AlpineAce27/Senior-Project-TVC-Guidance/Documentation/Pictures/01-29-24 TVC.jpg

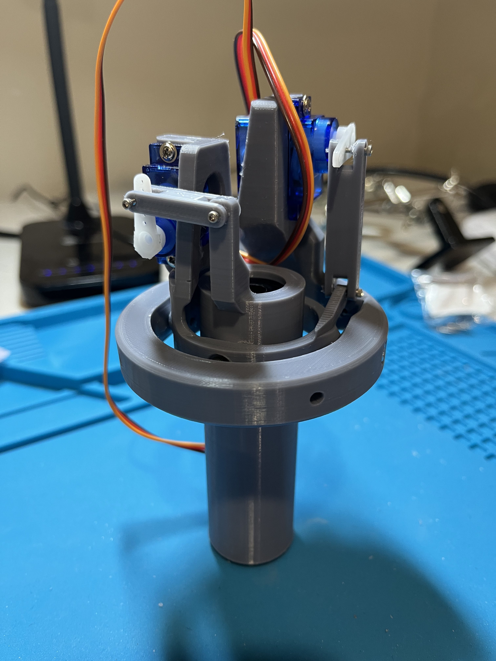
Documentation/Pictures/01-29-24 TVC.jpg
