AlpineAce27/Senior-Project-TVC-Guidance/Genesis Flight Computer/PCB Gerber Files/CAMOutputs/Assembly/R1 Schematic.txt

Partlist exported from C:/Users/Kimball/Documents/EAGLE/projects/Genesis Flight Computer/R1 Schematic.sch at 3/7/2024 11:54 AM

Qty Value                             Device                            Package                           Parts                          Description                                                                                                                                                                                                                                           MF MPN OC_FARNELL OC_NEWARK POPULARITY
3                                     LED3MM                            LED3MM                            BLUE_LED, GREEN_LED, RED_LED   LED                                                                                                                                                                                                                                                                               97        
1                                     MOSFET-NGDS_TO220V                TO220V                            PYRO_MOSFET                    N-Channel Mosfet                                                                                                                                                                                                                                                                            
4                                     PINHD-1X3                         1X03                              SERVO1, SERVO2, SERVO3, SERVO4 PIN HEADER                                                                                                                                                                                                                                                                                  
1                                     PINHD-1X6                         1X06                              EXTRA_HEADERS                  PIN HEADER                                                                                                                                                                                                                                                                                  
1   1 uF                              CPOL-USE2,5-6E                    E2,5-6E                           C3                             POLARIZED CAPACITOR, American symbol                                                                                                                                                                                                                                                        
1   10 uF                             CPOL-USE2.5-6                     E2,5-6                            C2                             POLARIZED CAPACITOR, American symbol                                                                                                                                                                                                                                                        
1   140 ohm                           FLIPFLOP-RES                      0805-THM                          R2                             Flip Flop resistor                                                                                                                                                                                                                                                                          
1   1X2-3.5MM                         1X2-3.5MM                         1X2-3.5MM                         PYRO1                          3.5mm Terminal block                                                                                                                                                                                                                                                                        
1   1ohm                              FLIPFLOP-RES                      0805-THM                          R1-2                           Flip Flop resistor                                                                                                                                                                                                                                                                          
1   500ohm                            FLIPFLOP-RES                      0805-THM                          R1-1                           Flip Flop resistor                                                                                                                                                                                                                                                                          
1   7808T                             7808T                             TO220H                            IC1                            Positive VOLTAGE REGULATOR                                                                                                                                                                                                                                                        0         
1   90 ohm                            FLIPFLOP-RES                      0805-THM                          R1                             Flip Flop resistor                                                                                                                                                                                                                                                                          
1   ADAFRUIT_BMP280_BREAKOUT_STEMMAQT ADAFRUIT_BMP280_BREAKOUT_STEMMAQT ADAFRUIT_BMP280_BREAKOUT_STEMMAQT U$4                                                                                                                                                                                                                                                                                                                        
1   ADAFRUIT_MICRO_SD_BREAKOUT+       ADAFRUIT_MICRO_SD_BREAKOUT+       ADAFRUIT_MICRO_SD_BREAKOUT        U$2                                                                                                                                                                                                                                                                                                                        
1   ADAFRUIT_SP_SMT_512M_SD           ADAFRUIT_SP_SMT_512M_SD           ADAFRUIT_SPI_SMT_512M_SD          U$3                                                                                                                                                                                                                                                                                                                        
1   Arming Header                     PINHD-1X3                         1X03                              JP1                            PIN HEADER                                                                                                                                                                                                                                                                                  
1   F/TMB                             F/TMB                             F/TMB                             SG1                            BUZZER Source: Buerklin                                                                                                                                                                                                                                      unknown    unknown   1         
1   GY-521MPU6050                     GY-521MPU6050                     GY-521                            U1                                                                                                                                                                                                                                                                                                                         
1   TEENSY40                          TEENSY40                          TEENSY40                          U$1                            Teensy 4.0 device including POGO pins for pins 24 - 33, but not yet pins for D+ and D-.  Symbol layout is what works for me and may not suite everyone... that can be added or additional symbols can be created to be used in a modilied davie name.                                       
2   WIREPAD3,81/1,4                   WIREPAD3,81/1,4                   3,81/1,4                          BATT-GND, BATT-VIN             Wire PAD connect wire on PCB                                                                                                                                                                                                                                                      1
