AlpineAce27/Senior-Project-TVC-Guidance/Documentation/Pictures/02-22-24 Generic Graph.png

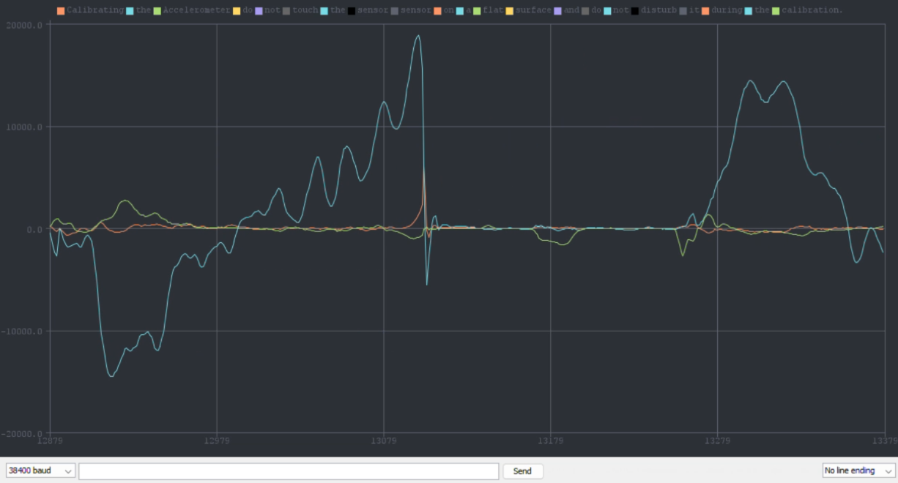
Documentation/Pictures/02-22-24 Generic Graph.png
