AlpineAce27/Senior-Project-TVC-Guidance/Documentation/Pictures/02-22-24 Genesis Flight Computer .png

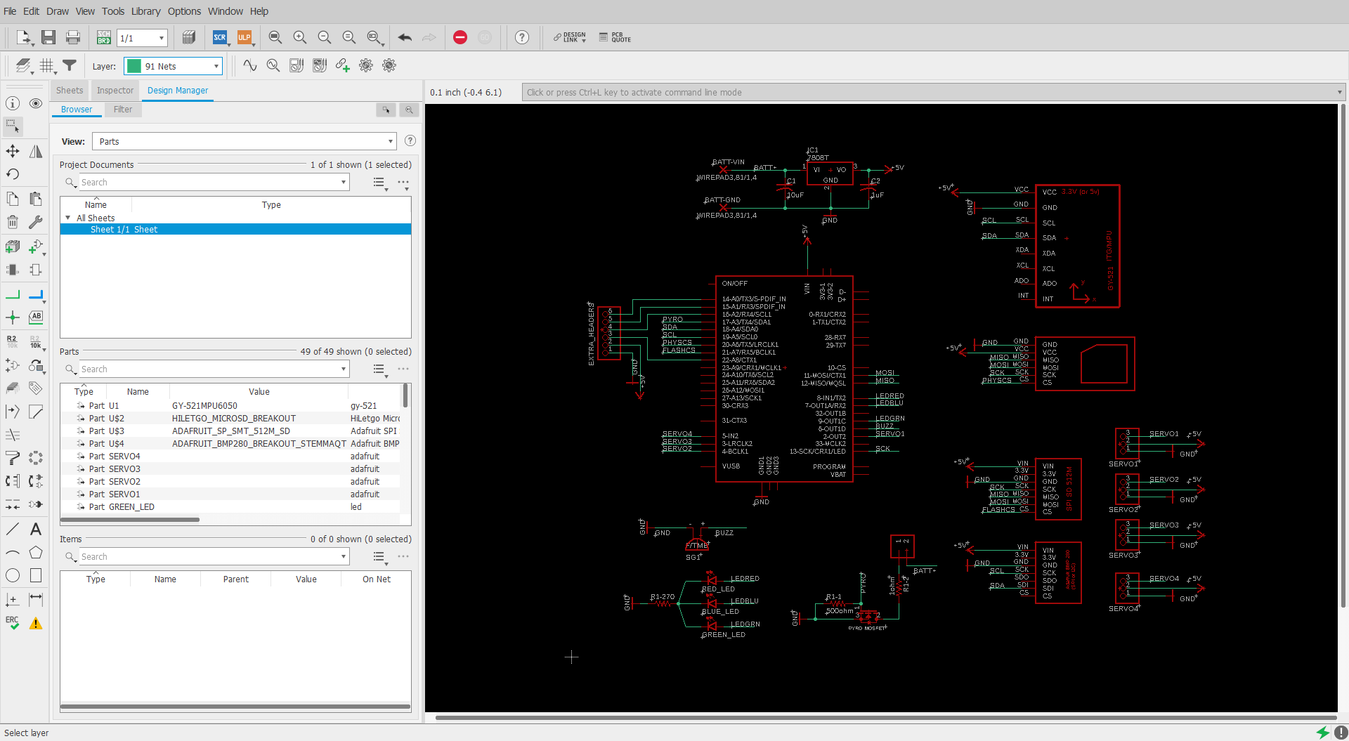
Documentation/Pictures/02-22-24 Genesis Flight Computer .png
