AlpineAce27/Senior-Project-TVC-Guidance/Documentation/Pictures/02-22-24 Genesis Launch Computer Board.png

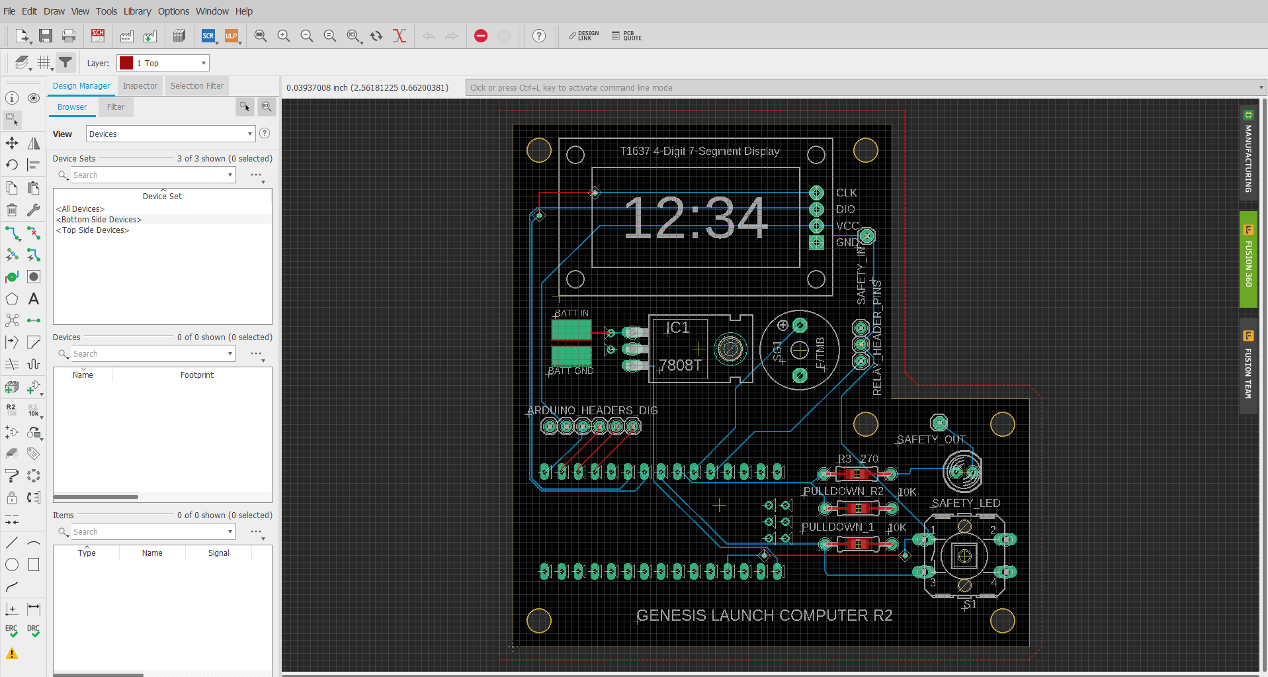
Documentation/Pictures/02-22-24 Genesis Launch Computer Board.png
