AlpineAce27/Senior-Project-TVC-Guidance/Documentation/Pictures/02-22-24 PID WIP Code.png

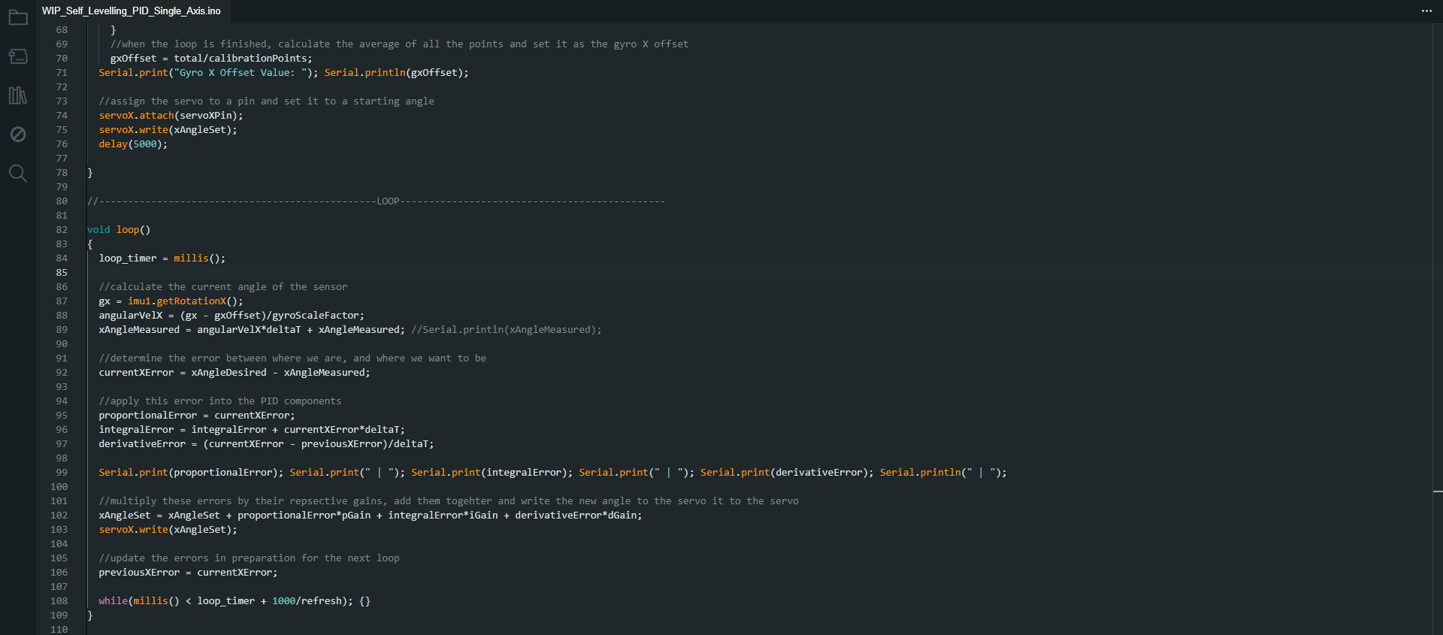
Documentation/Pictures/02-22-24 PID WIP Code.png
