AlpineAce27/Senior-Project-TVC-Guidance/Documentation/Pictures/Screenshot 2024-04-12 120832.png

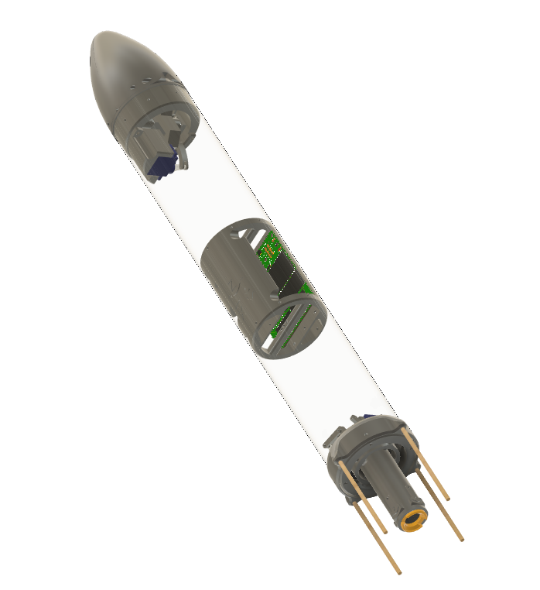
Documentation/Pictures/Screenshot 2024-04-12 120832.png
