AlpineAce27/Senior-Project-TVC-Guidance/Documentation/Pictures/Screenshot 2024-04-12 120903.png

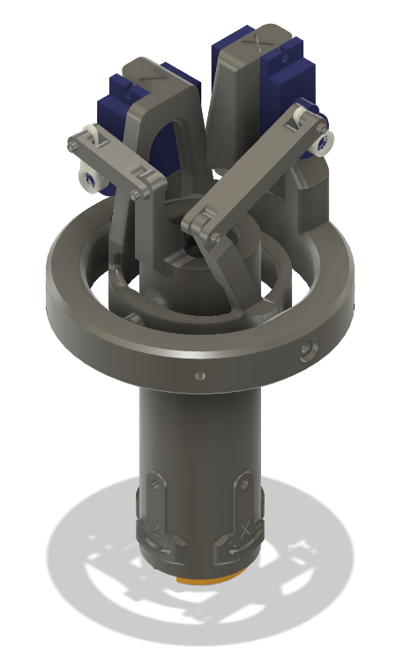
Documentation/Pictures/Screenshot 2024-04-12 120903.png
