AlpineAce27/Senior-Project-TVC-Guidance/Documentation/Pictures/Screenshot 2024-04-15 211354.png

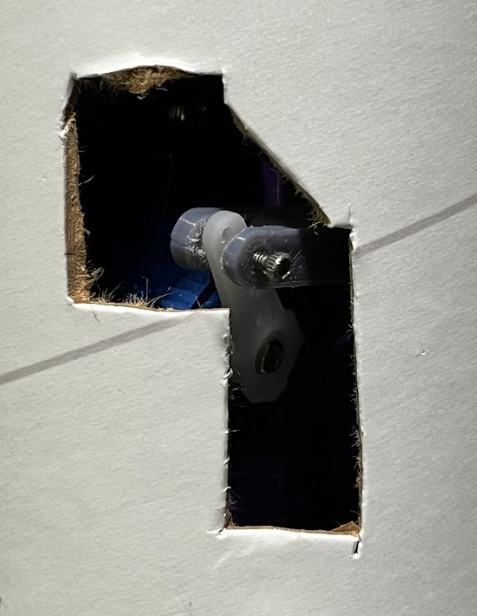
Documentation/Pictures/Screenshot 2024-04-15 211354.png
