AlpineAce27/Senior-Project-TVC-Guidance/Documentation/Pictures/Screenshot 2024-04-19 132711.png

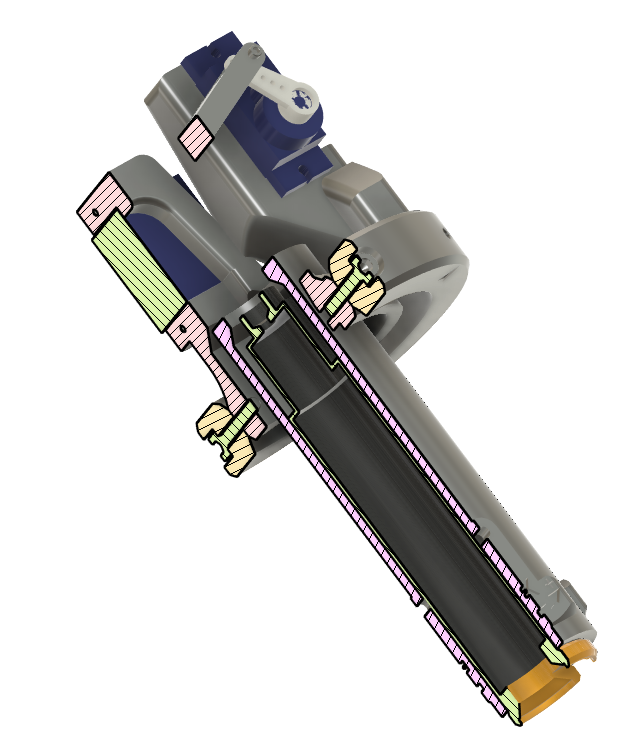
Documentation/Pictures/Screenshot 2024-04-19 132711.png
