AlpineAce27/Senior-Project-TVC-Guidance/Documentation/Pictures/Screenshot 2024-04-19 133153.png

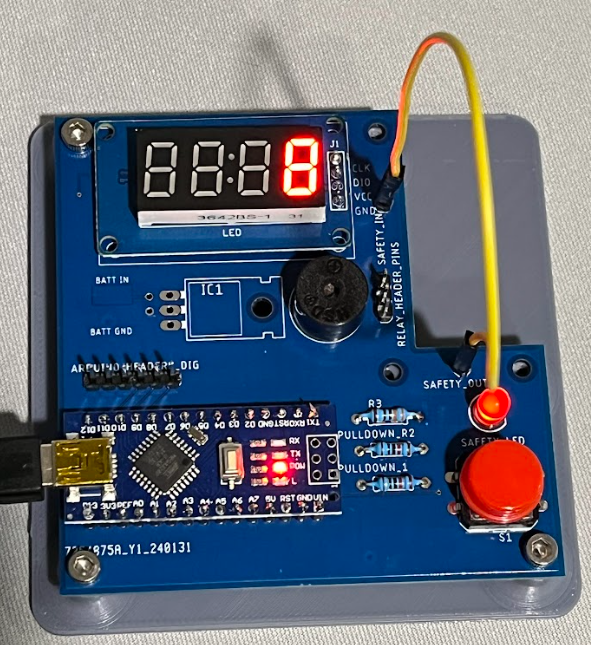
Documentation/Pictures/Screenshot 2024-04-19 133153.png
