AlpineAce27/Senior-Project-TVC-Guidance/Genesis Flight Computer/Documentation/Screenshot 2024-04-17 100612.png

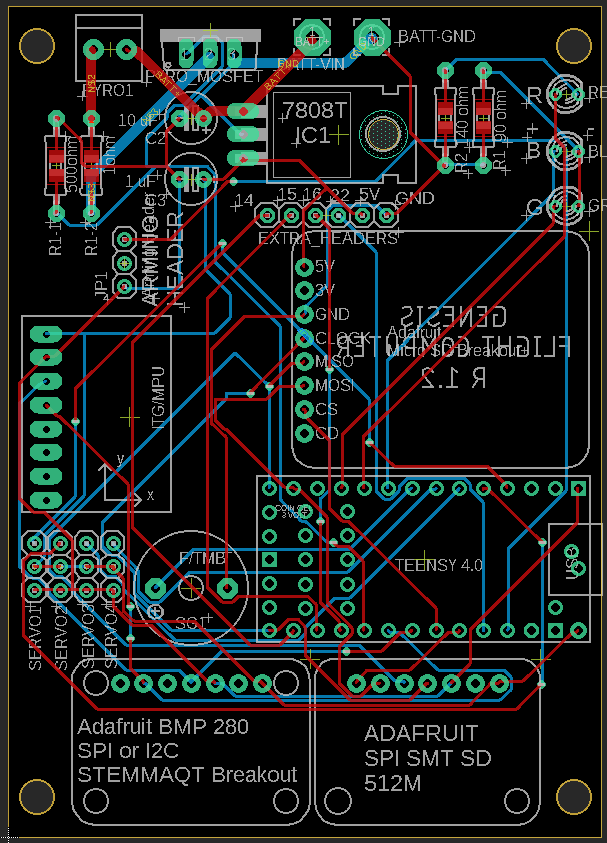
Genesis Flight Computer/Documentation/Screenshot 2024-04-17 100612.png
