AlpineAce27/Senior-Project-TVC-Guidance/Genesis Flight Computer/Documentation/Screenshot 2024-04-20 150324.png

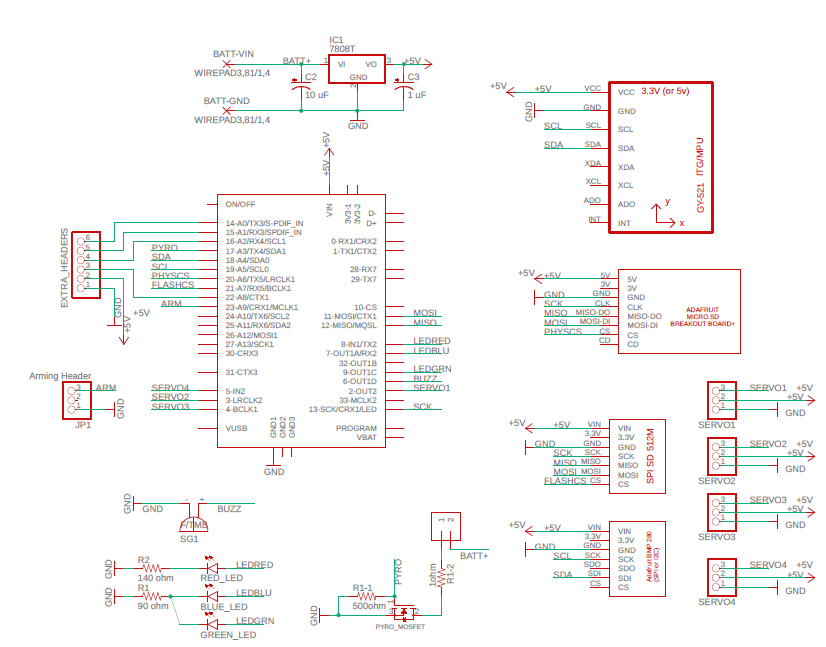
Genesis Flight Computer/Documentation/Screenshot 2024-04-20 150324.png
