AlpineAce27/Senior-Project-TVC-Guidance/Genesis Launch Computer/Documentation/GLC Schematic.png

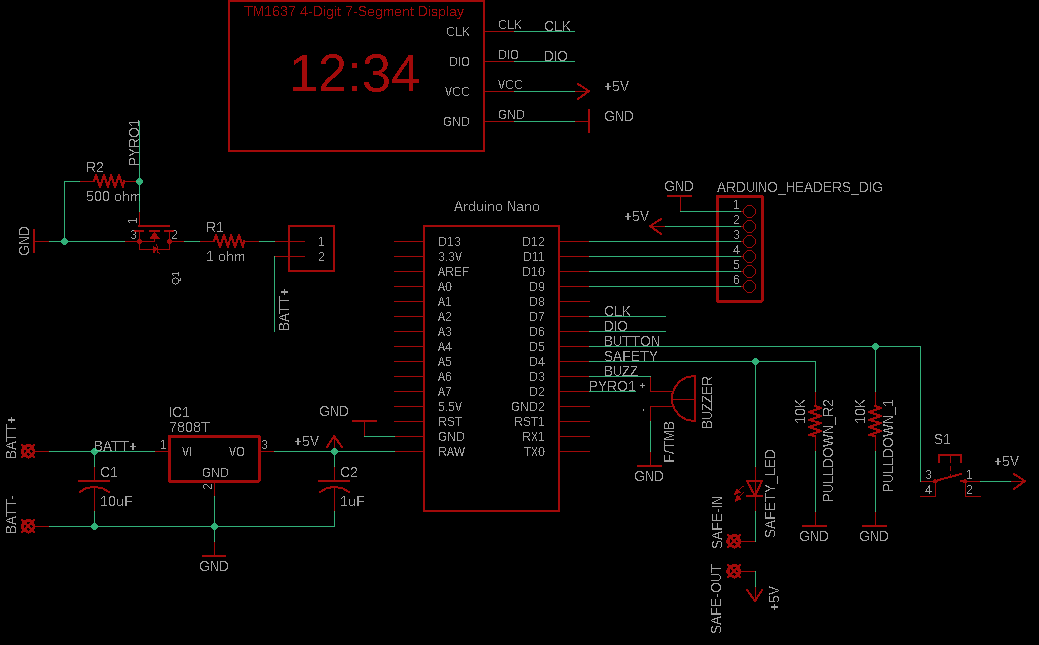
Genesis Launch Computer/Documentation/GLC Schematic.png
