AlpineAce27/Senior-Project-TVC-Guidance/Genesis Launch Computer/Documentation/Screenshot 2024-04-15 204919.png

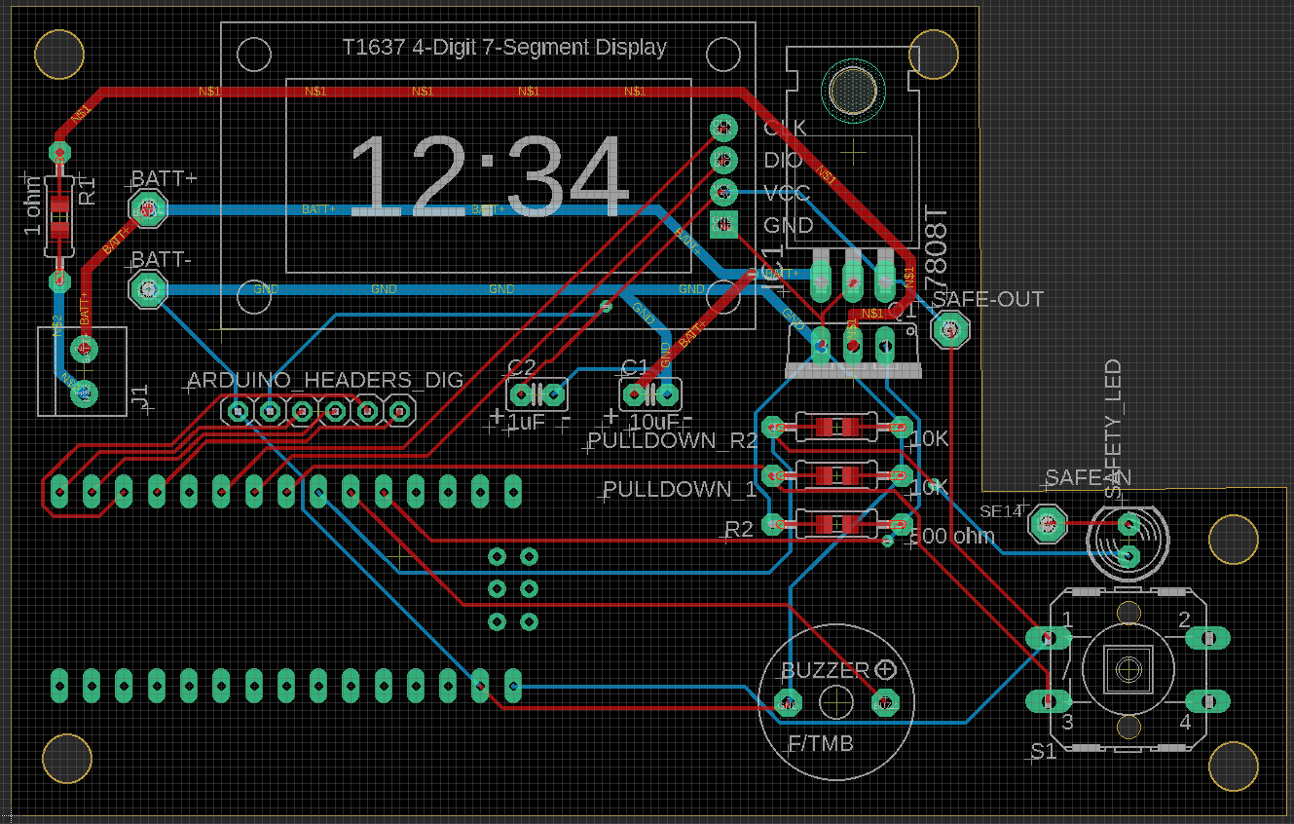
Genesis Launch Computer/Documentation/Screenshot 2024-04-15 204919.png
