AlpineAce27/Senior-Project-TVC-Guidance/Genesis Launch Computer/Documentation/Screenshot 2024-04-20 150143.png

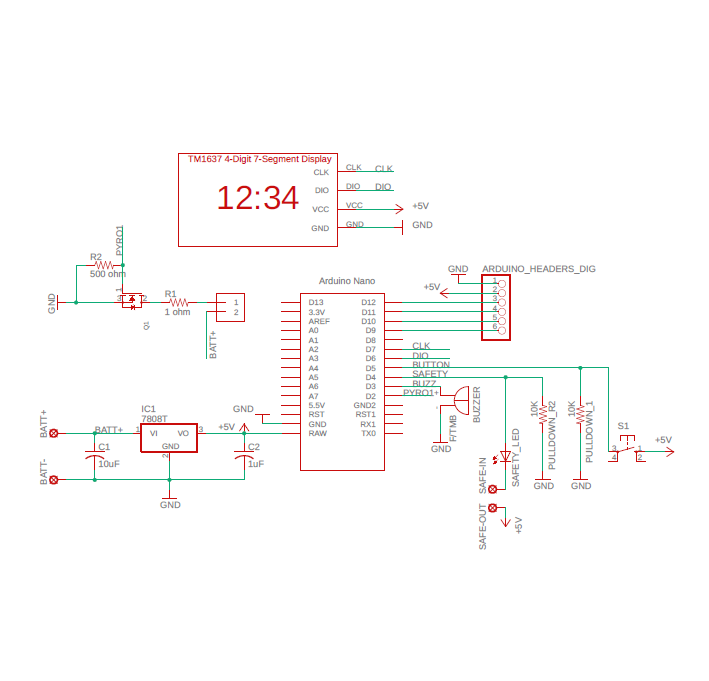
Genesis Launch Computer/Documentation/Screenshot 2024-04-20 150143.png
