AlpineAce27/Senior-Project-TVC-Guidance/Genesis Launch Computer/STLs/Case Top.stl

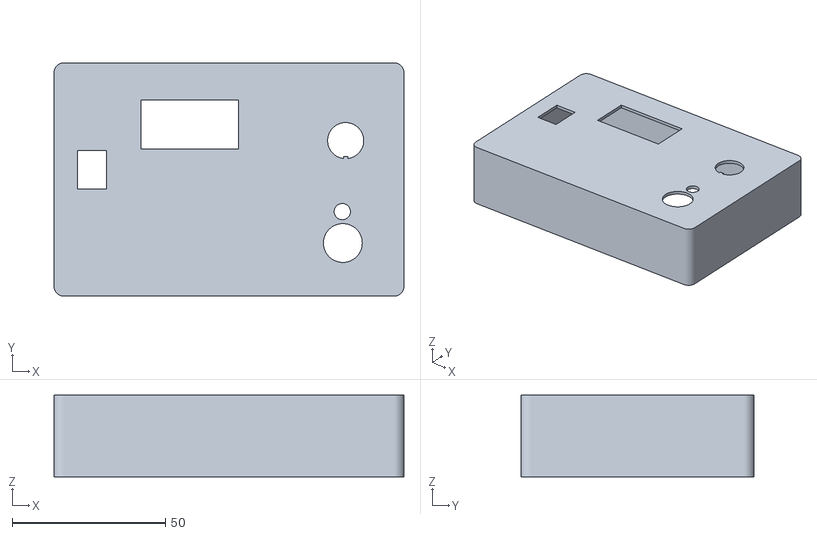
[picture p21: CAD file, 2024-03-28]
Genesis Launch Computer/STLs/Case Top.stl
114.3 x 76.2 x 26.7
