AlpineAce27/Senior-Project-TVC-Guidance/Genesis Rocket/STLs/Battery Spacer.stl

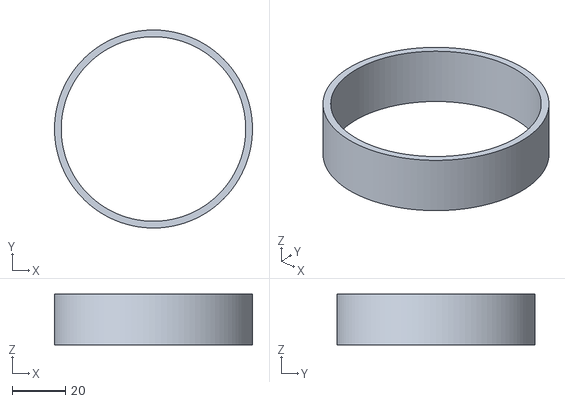
[picture p22: CAD file, 2024-04-20]
Genesis Rocket/STLs/Battery Spacer.stl
74.2 x 74.2 x 19.0
