AlpineAce27/Senior-Project-TVC-Guidance/Genesis Rocket/STLs/Launch Mount/Rocket-Side Launch Mount.stl

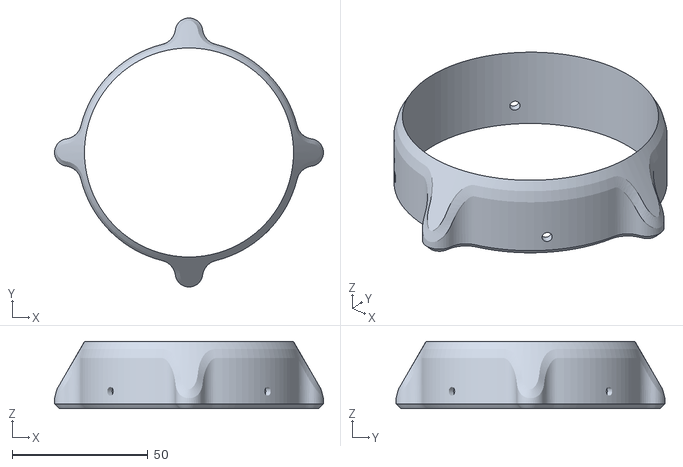
[picture p23: CAD file, 2024-02-09]
Genesis Rocket/STLs/Launch Mount/Rocket-Side Launch Mount.stl
99.1 x 99.1 x 24.7
