AlpineAce27/Senior-Project-TVC-Guidance/Genesis Rocket/STLs/Nosecone/Servo Mount.stl

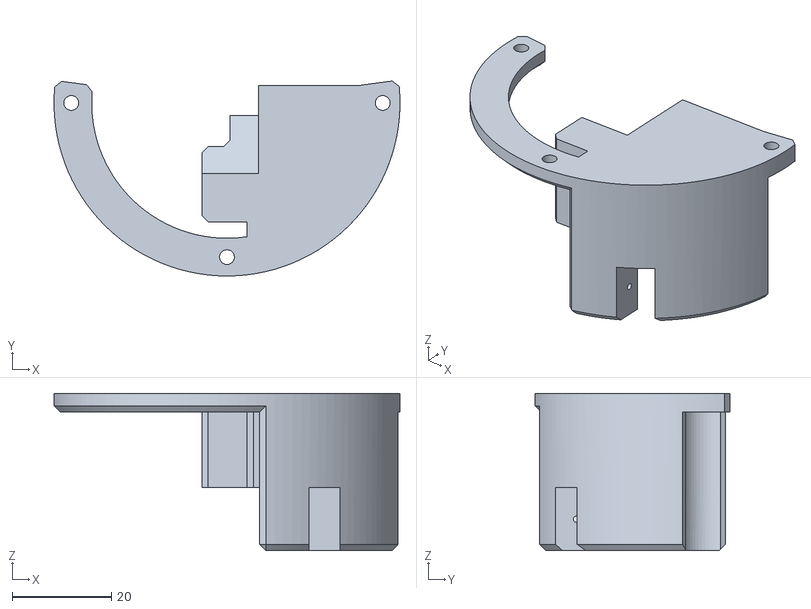
[picture p24: CAD file, 2024-03-28]
Genesis Rocket/STLs/Nosecone/Servo Mount.stl
69.8 x 39.4 x 31.8
