AlpineAce27/Senior-Project-TVC-Guidance/Genesis Rocket/STLs/TVC/Motor Sleeve.stl

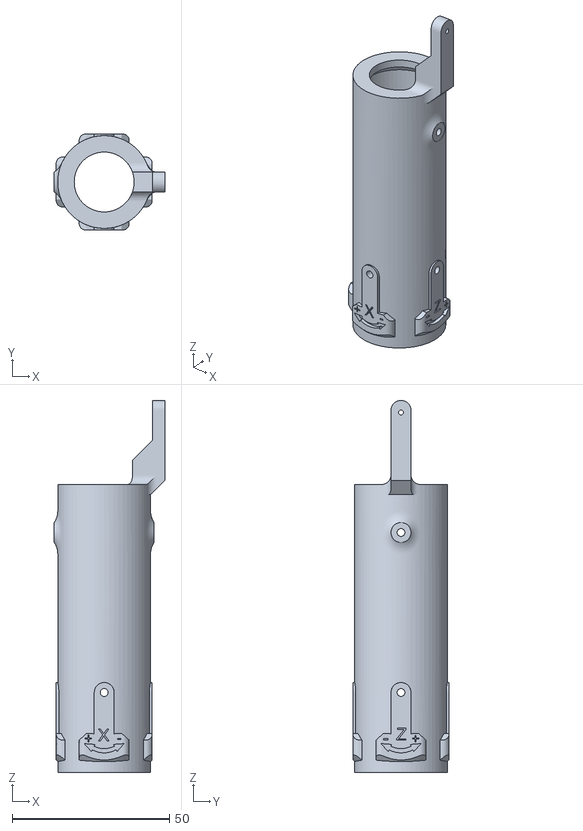
[picture p25: CAD file, 2024-03-12]
Genesis Rocket/STLs/TVC/Motor Sleeve.stl
35.1 x 30.5 x 118.1
