AlpineAce27/Senior-Project-TVC-Guidance/Miniprojects/Self Levelling PID (Single Axis)/STLs/Linkage Arm.stl

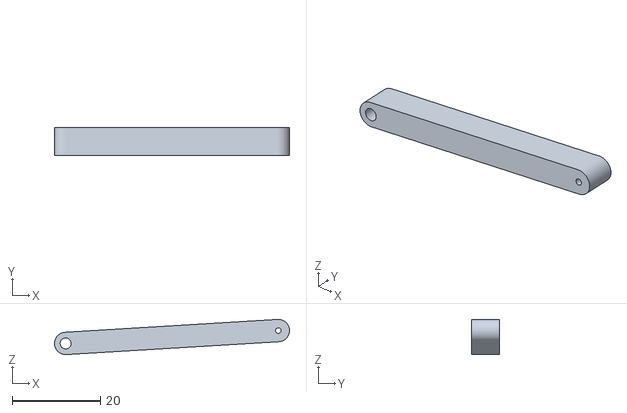
[picture p26: CAD file, 2024-04-02]
Miniprojects/Self Levelling PID (Single Axis)/STLs/Linkage Arm.stl
53.4 x 6.35 x 7.99
