AlpineAce27/Senior-Project-TVC-Guidance/Test Stand/STLs/Outer Ring.stl

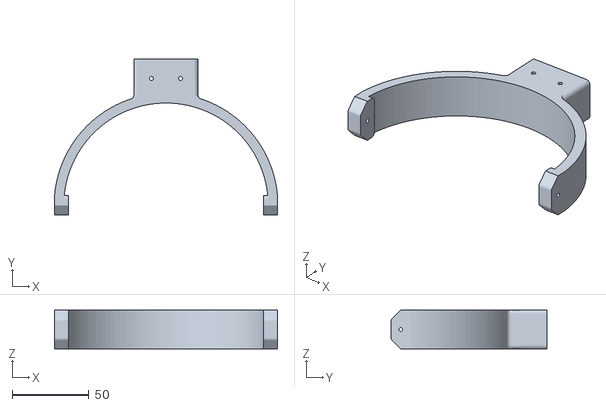
[picture p27: CAD file, 2024-04-12]
Test Stand/STLs/Outer Ring.stl
145.5 x 101.7 x 25.4
