AlpineAce27/Senior-Project-TVC-Guidance/Genesis Launch Computer/STLs/Case Bottom.stl

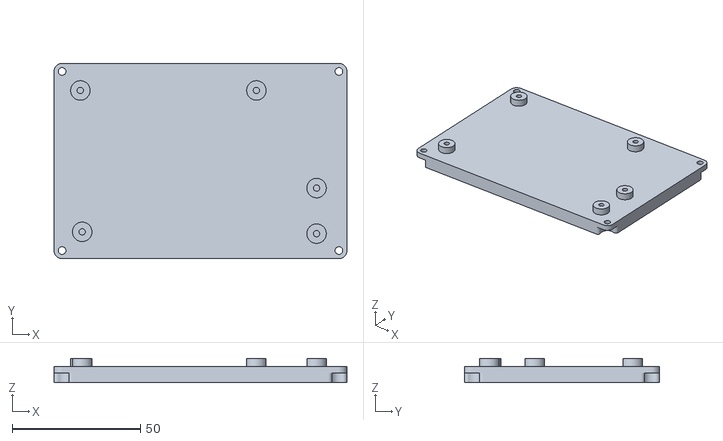
[picture p28: CAD file, 2024-03-12]
Genesis Launch Computer/STLs/Case Bottom.stl
114.3 x 76.2 x 9.52
