AlpineAce27/Senior-Project-TVC-Guidance/Genesis Rocket/STLs/Ejection Charge Powder Container.stl

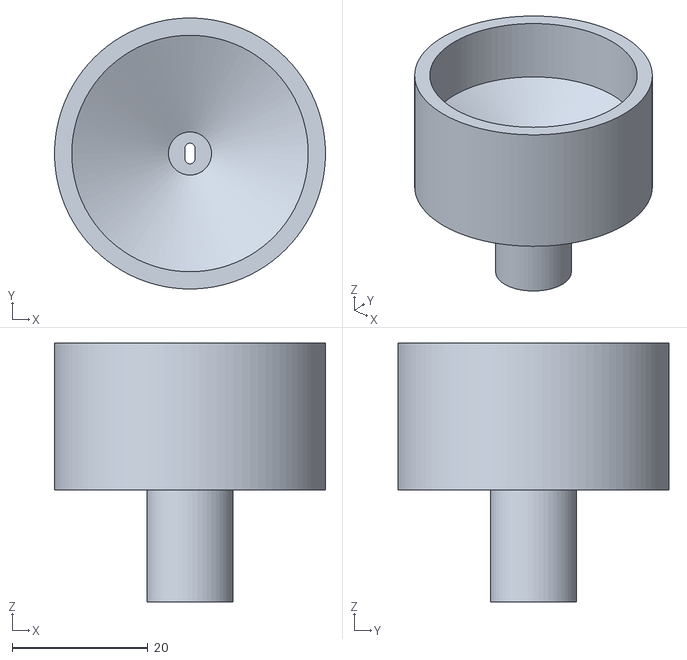
[picture p29: CAD file, 2024-04-12]
Genesis Rocket/STLs/Ejection Charge Powder Container.stl
39.9 x 39.9 x 38.1
