AlpineAce27/Senior-Project-TVC-Guidance/Genesis Rocket/STLs/Launch Mount/Pad-Side Launch Mount.stl

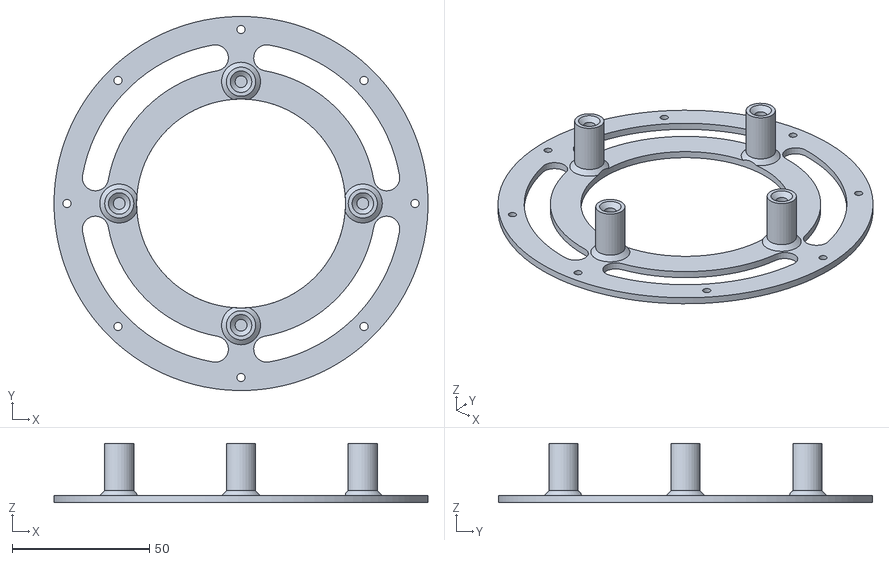
[picture p30: CAD file, 2024-02-09]
Genesis Rocket/STLs/Launch Mount/Pad-Side Launch Mount.stl
136.5 x 136.5 x 21.6
