AlpineAce27/Senior-Project-TVC-Guidance/Genesis Rocket/STLs/Nosecone/Piston Slider.stl

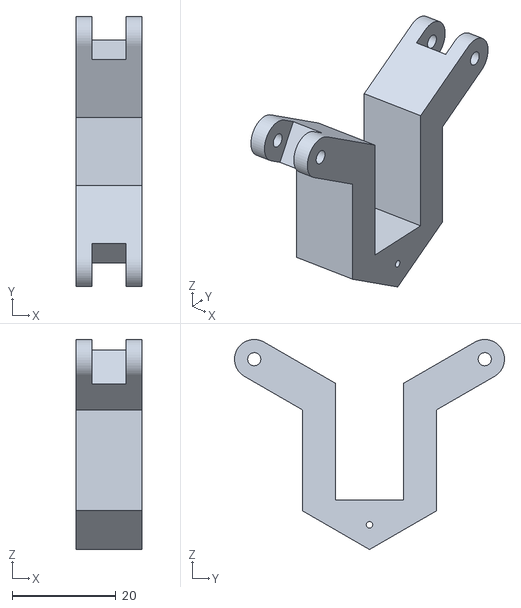
[picture p31: CAD file, 2024-03-28]
Genesis Rocket/STLs/Nosecone/Piston Slider.stl
12.7 x 52.1 x 40.5
