AlpineAce27/Senior-Project-TVC-Guidance/Genesis Rocket/STLs/TVC/Outer Gimbal Ring.stl

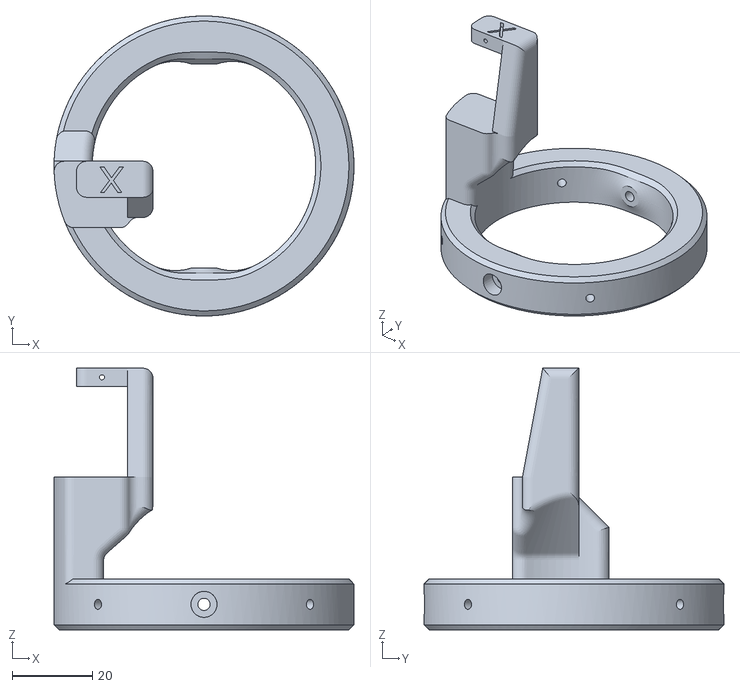
[picture p32: CAD file, 2024-03-12]
Genesis Rocket/STLs/TVC/Outer Gimbal Ring.stl
74.7 x 74.7 x 65.2
