AlpineAce27/Senior-Project-TVC-Guidance/Miniprojects/Self Levelling PID (Single Axis)/STLs/IMU Arm.stl

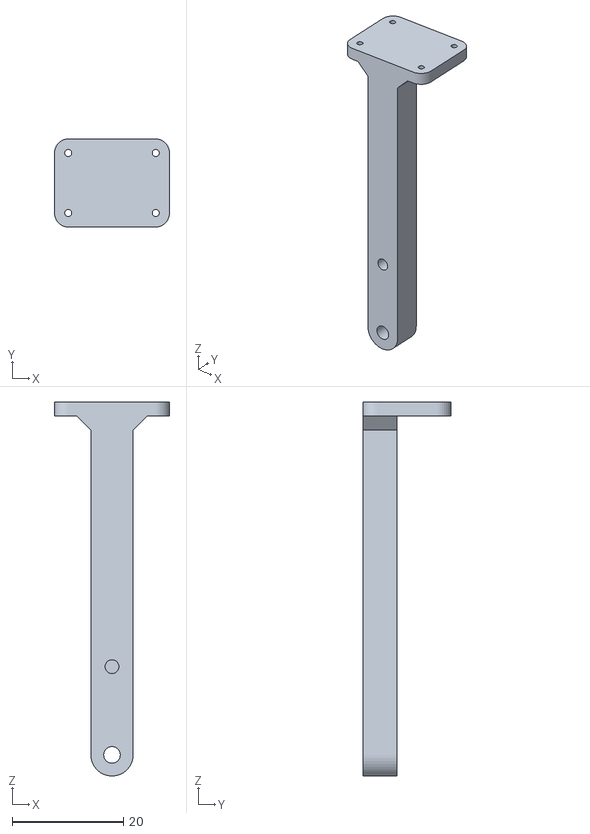
[picture p33: CAD file, 2024-04-02]
Miniprojects/Self Levelling PID (Single Axis)/STLs/IMU Arm.stl
20.7 x 15.9 x 67.3
