AlpineAce27/Senior-Project-TVC-Guidance/Test Stand/STLs/Thrust Meauring RC Motor Plate.stl

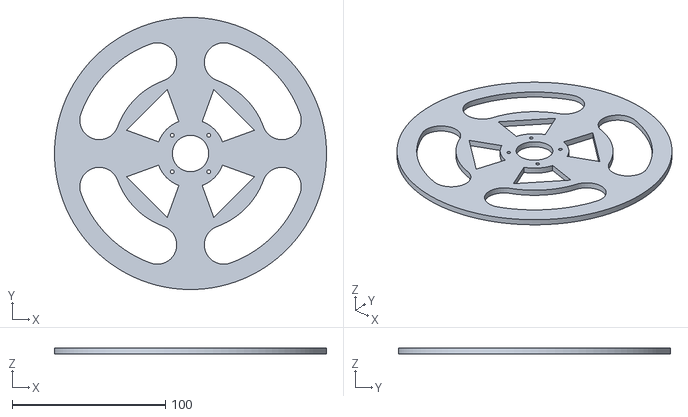
[picture p34: CAD file, 2024-04-12]
Test Stand/STLs/Thrust Meauring RC Motor Plate.stl
177.8 x 177.8 x 3.81
