AlpineAce27/Senior-Project-TVC-Guidance/Genesis Launch Computer/STLs/WIP Base.stl

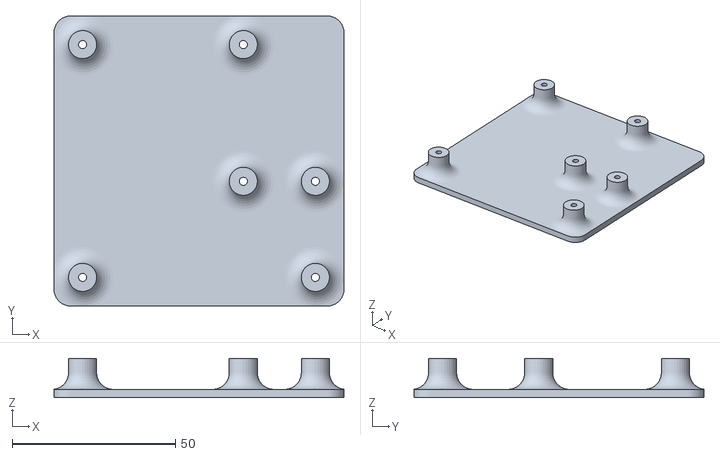
[picture p35: CAD file, 2024-02-09]
Genesis Launch Computer/STLs/WIP Base.stl
88.9 x 88.9 x 12.1
