AlpineAce27/Senior-Project-TVC-Guidance/Genesis Rocket/STLs/Nosecone/Servo Linkage.stl

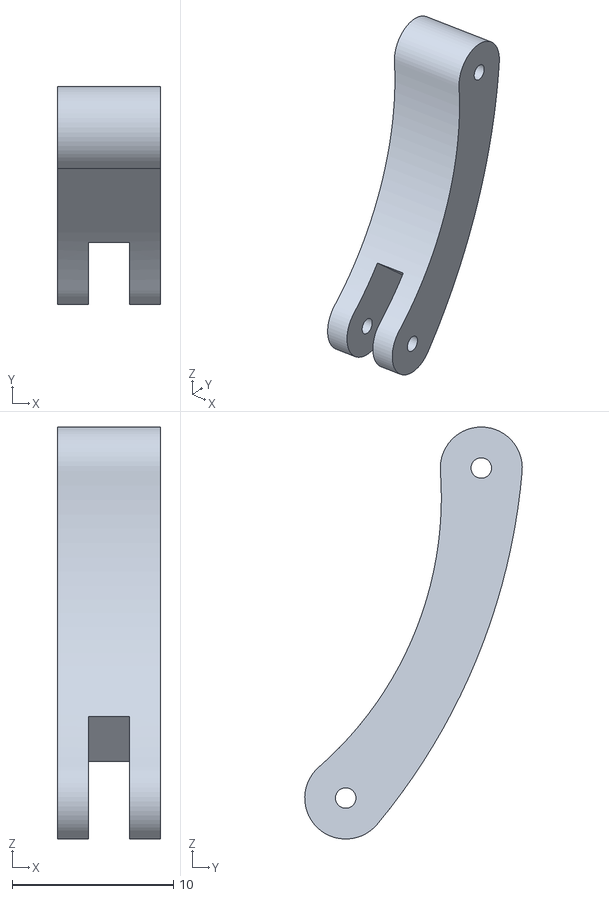
[picture p36: CAD file, 2024-03-28]
Genesis Rocket/STLs/Nosecone/Servo Linkage.stl
6.35 x 13.5 x 25.5
