AlpineAce27/Senior-Project-TVC-Guidance/Genesis Rocket/STLs/Recovery Piston Slider.stl

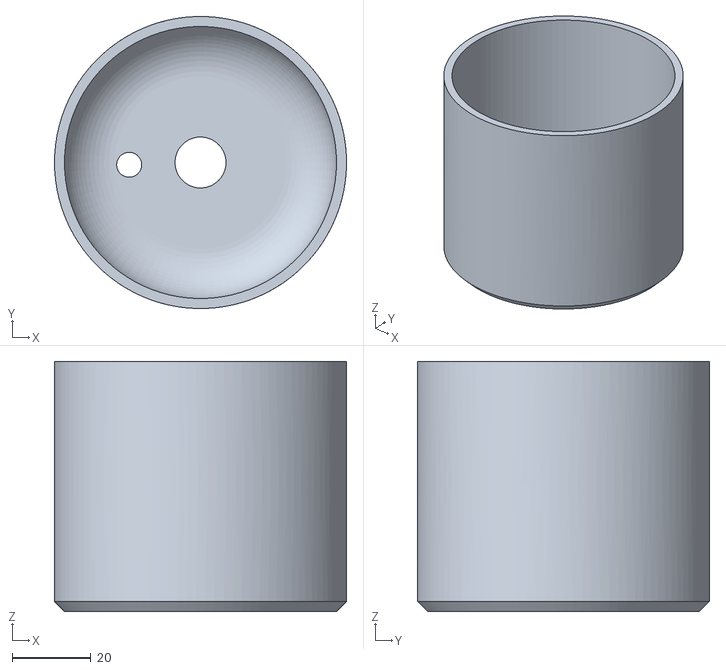
[picture p37: CAD file, 2024-04-12]
Genesis Rocket/STLs/Recovery Piston Slider.stl
74.2 x 74.2 x 63.5
