AlpineAce27/Senior-Project-TVC-Guidance/Genesis Rocket/STLs/TVC/Inner Gimbal Ring.stl

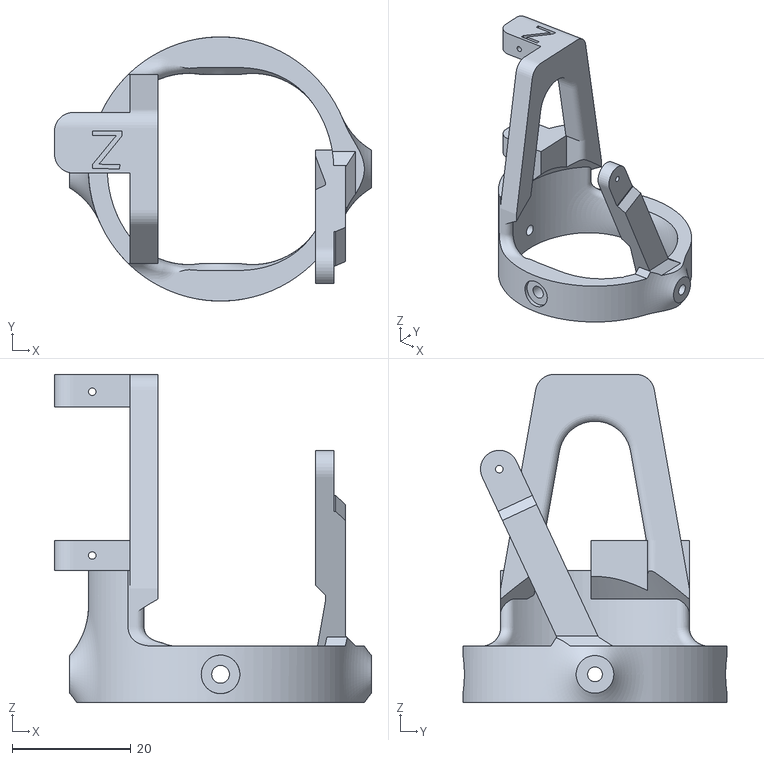
[picture p38: CAD file, 2024-03-12]
Genesis Rocket/STLs/TVC/Inner Gimbal Ring.stl
53.3 x 44.5 x 55.2
