AlpineAce27/Senior-Project-TVC-Guidance/Miniprojects/Self Levelling PID (Single Axis)/STLs/Base.stl

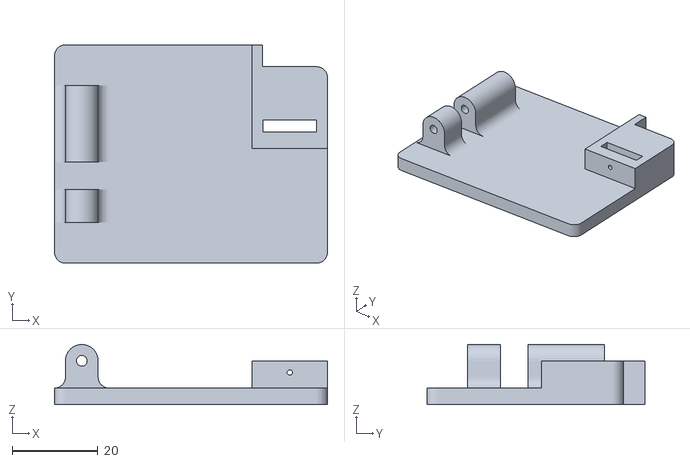
[picture p39: CAD file, 2024-04-02]
Miniprojects/Self Levelling PID (Single Axis)/STLs/Base.stl
63.5 x 50.8 x 14.0
