AlpineAce27/Senior-Project-TVC-Guidance/Test Stand/STLs/2x4 Mount.stl

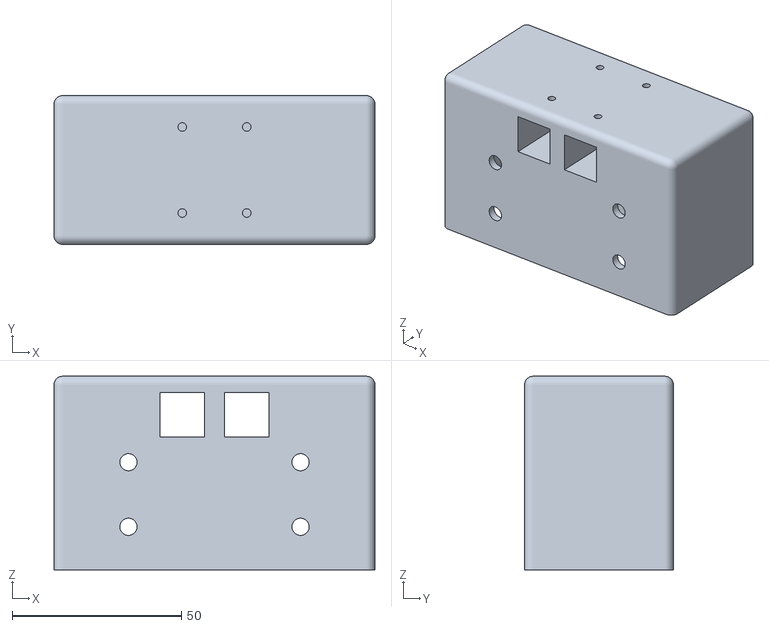
[picture p40: CAD file, 2024-04-02]
Test Stand/STLs/2x4 Mount.stl
94.7 x 43.9 x 57.2
