AlpineAce27/Senior-Project-TVC-Guidance/Genesis Rocket/STLs/Electronics Sled.stl

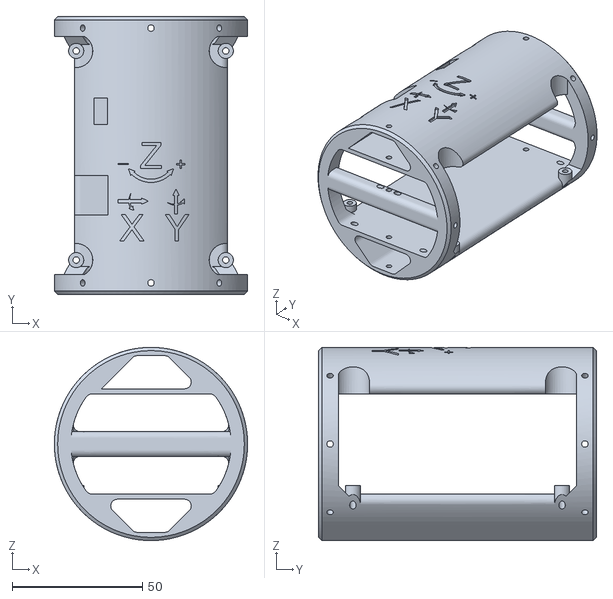
[picture p41: CAD file, 2024-03-28]
Genesis Rocket/STLs/Electronics Sled.stl
74.2 x 106.7 x 74.2
