AlpineAce27/Senior-Project-TVC-Guidance/Genesis Rocket/STLs/Nosecone/RC Motor Adapter.stl

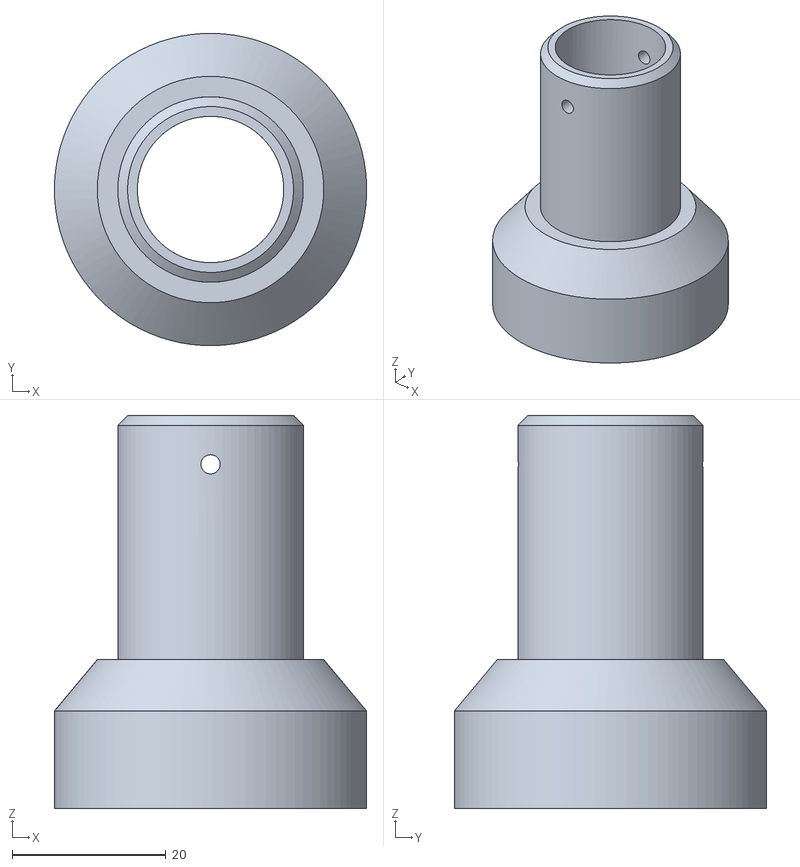
[picture p42: CAD file, 2024-03-28]
Genesis Rocket/STLs/Nosecone/RC Motor Adapter.stl
40.6 x 40.6 x 51.1
