AlpineAce27/Senior-Project-TVC-Guidance/Genesis Rocket/STLs/TVC/Inner Linkage Arm.stl

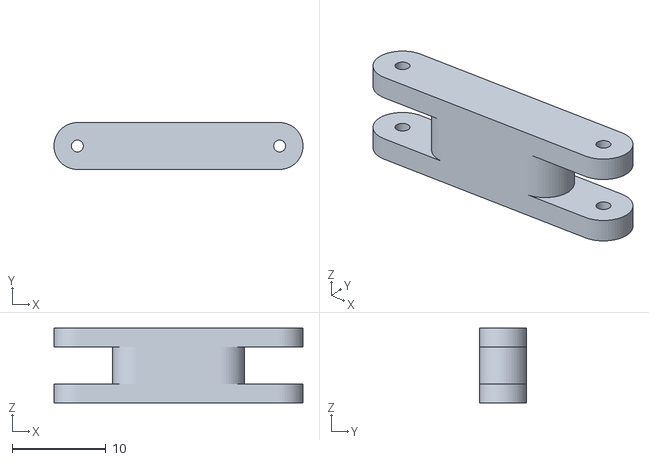
[picture p43: CAD file, 2024-01-30]
Genesis Rocket/STLs/TVC/Inner Linkage Arm.stl
26.6 x 5.00 x 8.00
