AlpineAce27/Senior-Project-TVC-Guidance/Test Stand/STLs/Inner Ring-skeletalFrameDia.stl

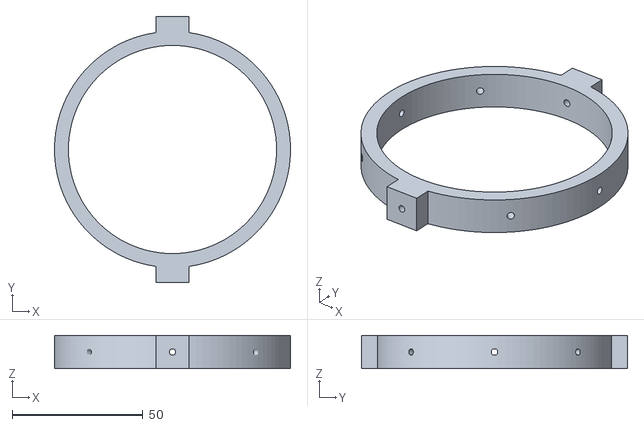
[picture p44: CAD file, 2024-03-28]
Test Stand/STLs/Inner Ring-skeletalFrameDia.stl
90.2 x 101.6 x 12.7
