AlpineAce27/Senior-Project-TVC-Guidance/Genesis Rocket/STLs/Nosecone/Base.stl

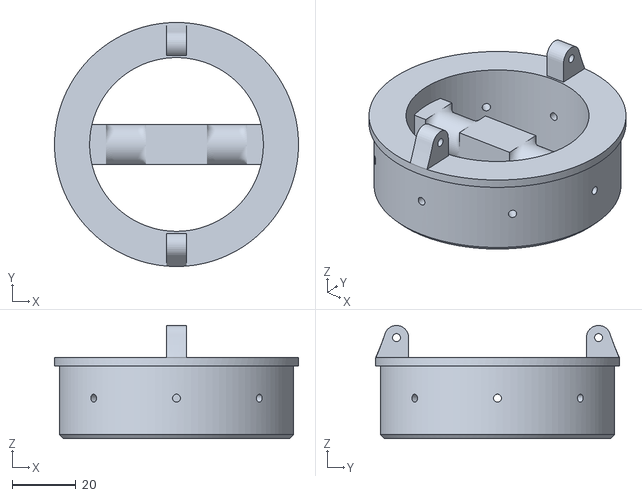
[picture p45: CAD file, 2024-03-28]
Genesis Rocket/STLs/Nosecone/Base.stl
76.7 x 76.7 x 35.6
