AlpineAce27/Senior-Project-TVC-Guidance/Genesis Rocket/STLs/PCB Breakout Board Brace Block.stl

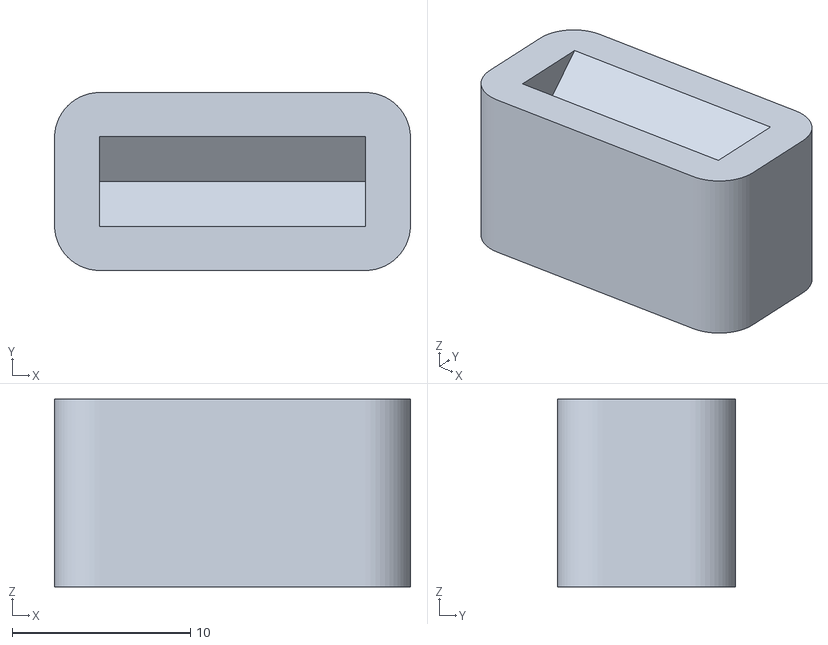
[picture p46: CAD file, 2024-03-15]
Genesis Rocket/STLs/PCB Breakout Board Brace Block.stl
20.0 x 10.0 x 10.5
