AlpineAce27/Senior-Project-TVC-Guidance/Test Stand/STLs/Skeletal Frame.stl

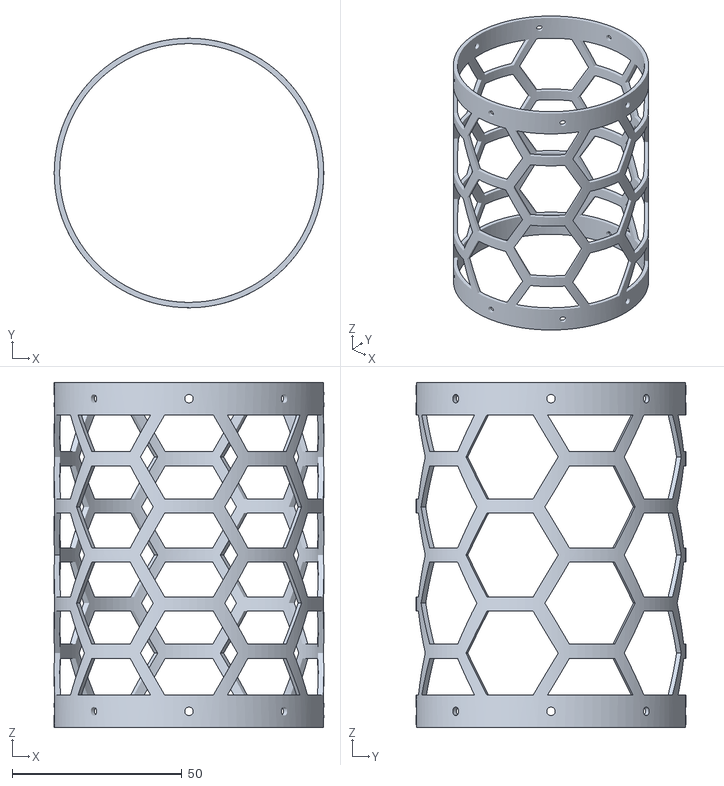
[picture p47: CAD file, 2024-03-28]
Test Stand/STLs/Skeletal Frame.stl
79.4 x 79.4 x 101.6
