AlpineAce27/Senior-Project-TVC-Guidance/Genesis Rocket/STLs/Nosecone/Fairing Half.stl

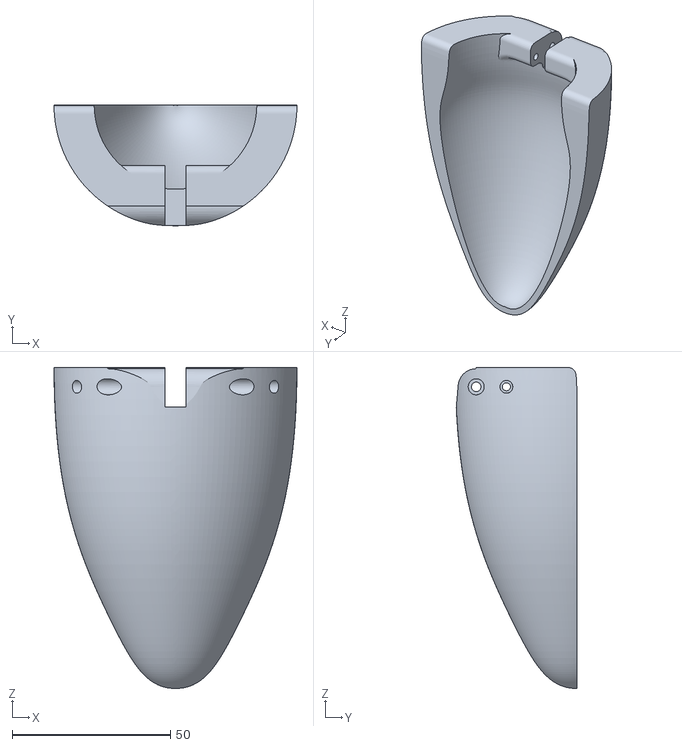
[picture p48: CAD file, 2024-03-12]
Genesis Rocket/STLs/Nosecone/Fairing Half.stl
76.7 x 38.1 x 101.3
