AlpineAce27/Senior-Project-TVC-Guidance/Genesis Rocket/STLs/TVC/Outer Linkage Arm.stl

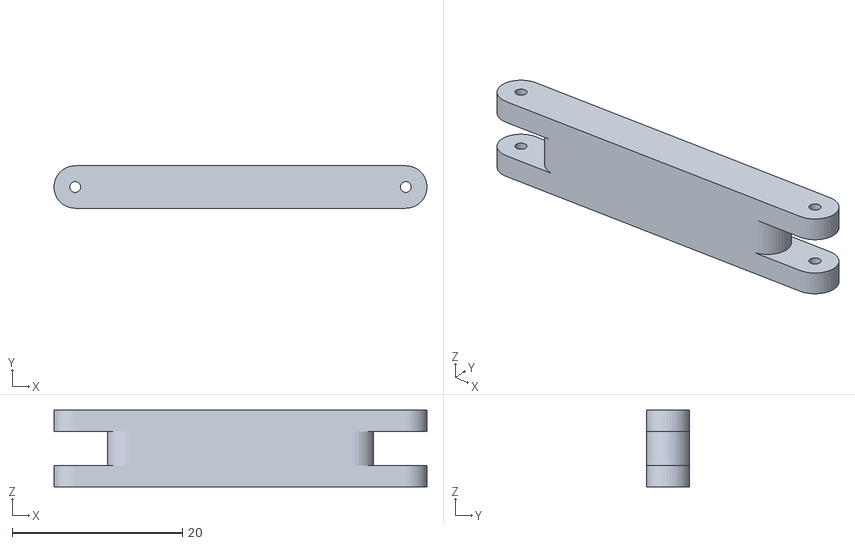
[picture p49: CAD file, 2024-01-30]
Genesis Rocket/STLs/TVC/Outer Linkage Arm.stl
43.8 x 5.00 x 9.00
