AlpineAce27/Senior-Project-TVC-Guidance/Test Stand/STLs/Skeletal Frame Joiner.stl

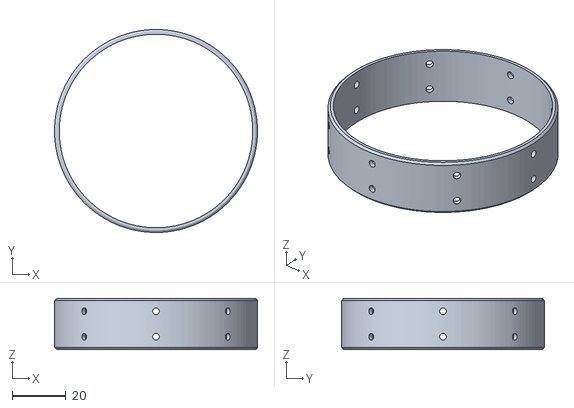
[picture p50: CAD file, 2024-03-28]
Test Stand/STLs/Skeletal Frame Joiner.stl
75.7 x 75.7 x 19.0
