AlpineAce27/Senior-Project-TVC-Guidance/Genesis Rocket/STLs/Nosecone/Linkage.stl

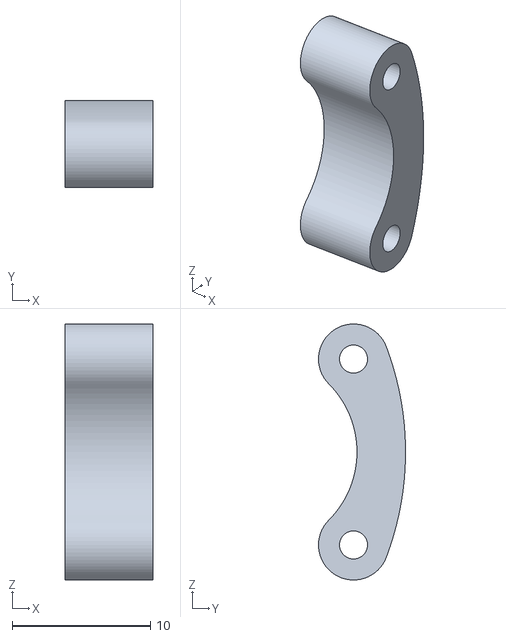
[picture p51: CAD file, 2024-03-12]
Genesis Rocket/STLs/Nosecone/Linkage.stl
6.35 x 6.31 x 18.5
