AlpineAce27/Senior-Project-TVC-Guidance/Test Stand/STLs/Inner Ring-bodyTubeDia.stl

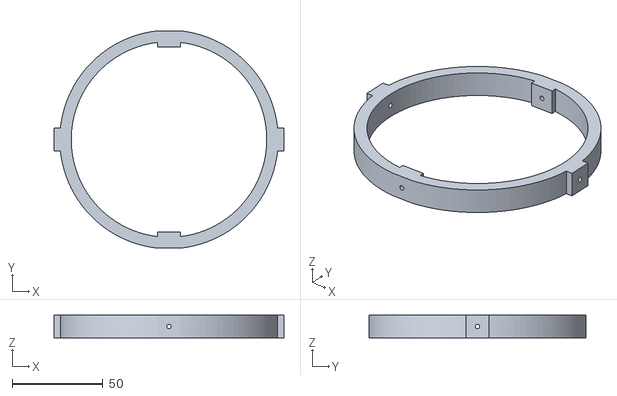
[picture p52: CAD file, 2024-02-12]
Test Stand/STLs/Inner Ring-bodyTubeDia.stl
127.0 x 120.0 x 12.7
