AlpineAce27/Senior-Project-TVC-Guidance/(list of files, cad)

Other CAD files:
Test Stand/STLs/Body1.stl
Test Stand/STLs/Rocket Mount.stl
Genesis Rocket/STLs/TVC/Servo Horn Washers.stl
