AlpineAce27/Senior-Project-TVC-Guidance/Documentation/Pictures/02-22-24 Genesis Rocket Assembly.png

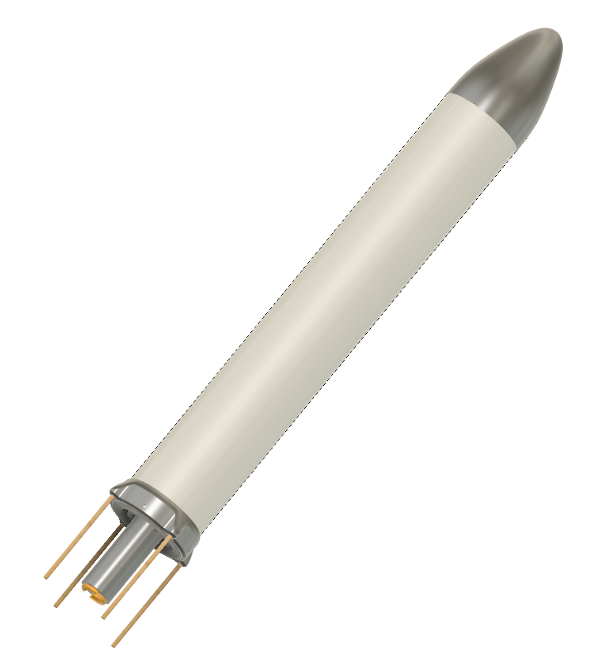
Documentation/Pictures/02-22-24 Genesis Rocket Assembly.png
