AlpineAce27/Senior-Project-TVC-Guidance/Documentation/Printable Remove Before Launch tag.png

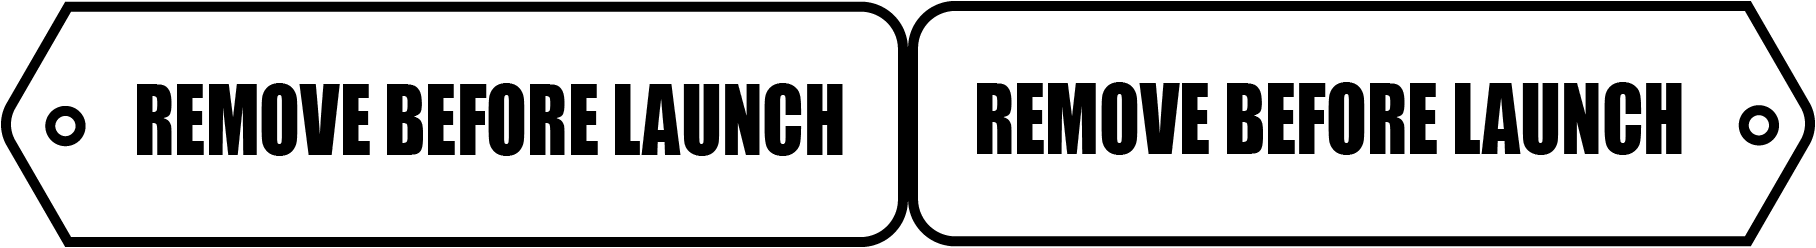
Documentation/Printable Remove Before Launch tag.png
