AlpineAce27/Senior-Project-TVC-Guidance/Documentation/Cost Breakdown.pdf

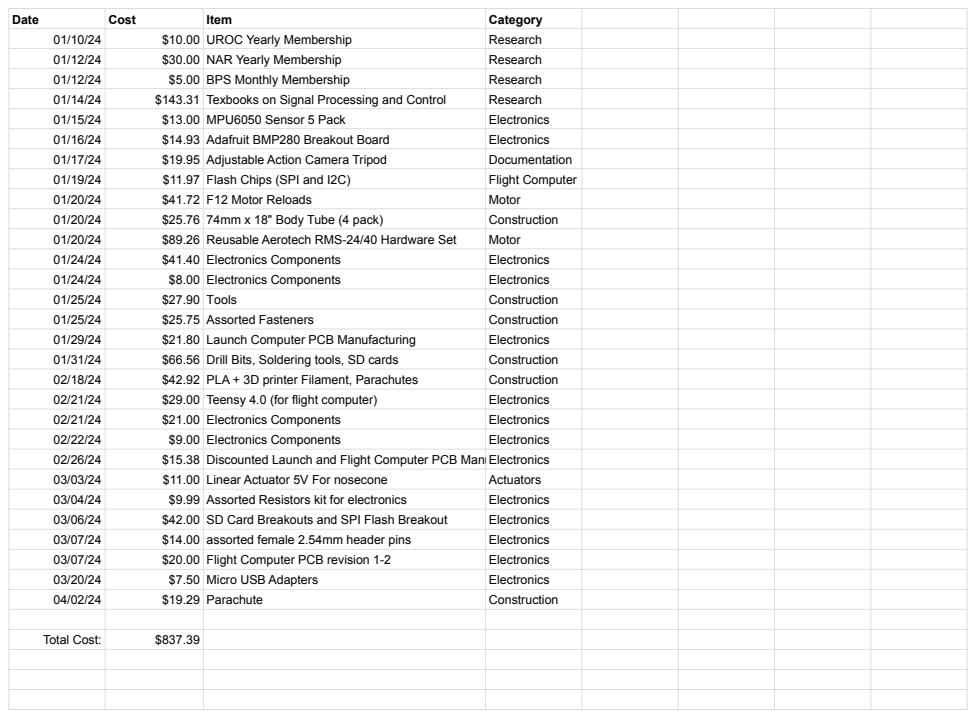
[picture p56: page 1]
Date; Cost; Item; Category; $10.00 UROC Yearly Membership; Research; $30.00 NAR Yearly Membership; $5.00 BPS Monthly Membership; $143.31 Texbooks on Signal Processing and Control; $13.00 MPU6050 Sensor 5 Pack; Electronics; $14.93 Adafruit BMP280 Breakout Board; $19.95 Adjustable Action Camera Tripod; Documentation; $11.97 Flash Chips (SPI and I2C); Flight Computer; $41.72 F12 Motor Reloads; Motor; $25.76 74mm x 18" Body Tube (4 pack); Construction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

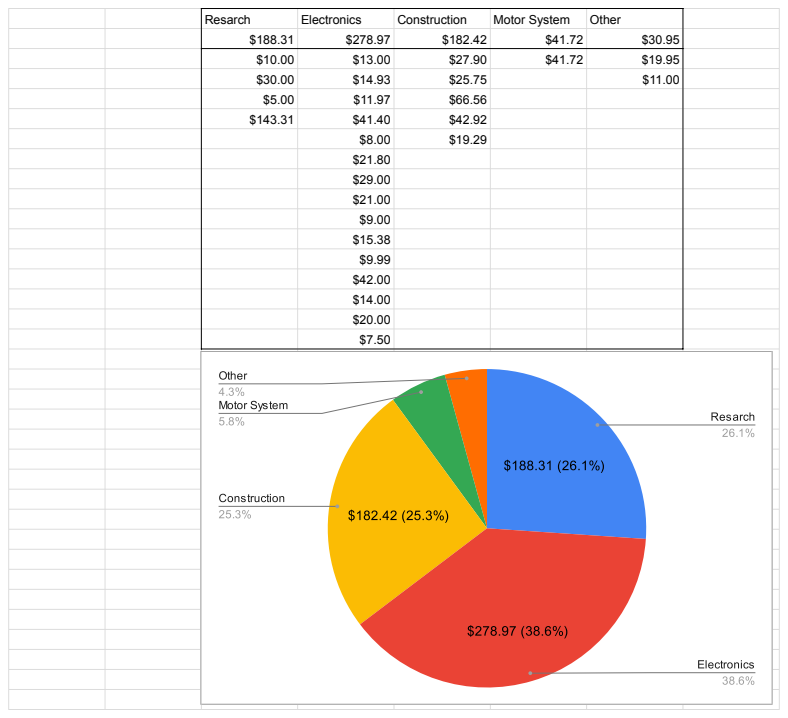
[picture p57: page 2]
Resarch; Electronics; Construction; Motor System; Other
