AlpineAce27/Senior-Project-TVC-Guidance/Genesis Launch Computer/Documentation/Genesis Launch Computer Schematic.pdf

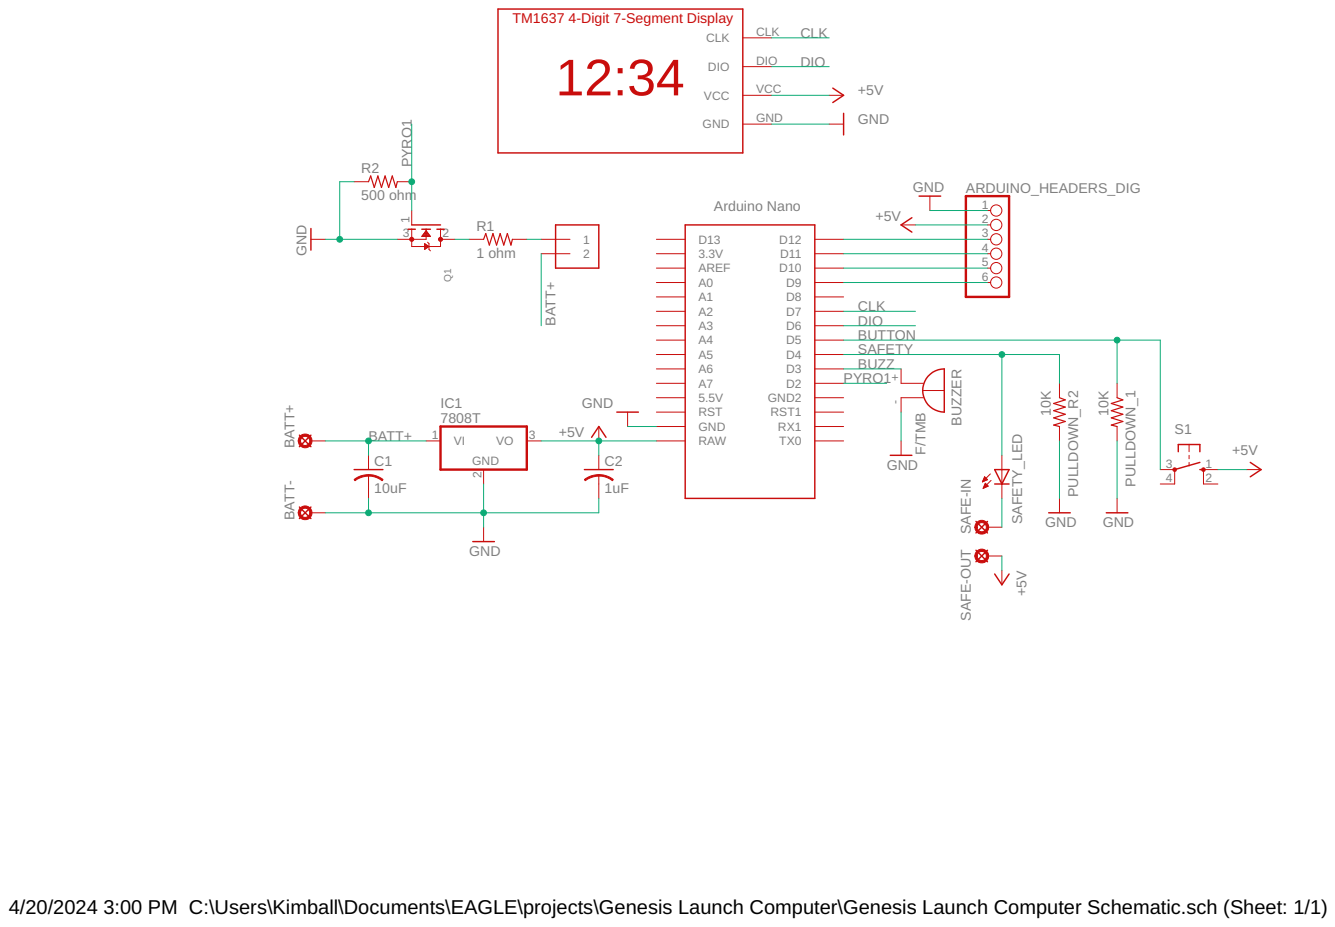
[picture p58: page 1]

SAFE-IN SAFE-OUT

4/20/2024 3:00 PM C:\Users\Kimball\Documents\EAGLE\projects\Genesis Launch Computer\Genesis Launch Computer Schematic.sch (Sheet: 1/1)
