AlpineAce27/Senior-Project-TVC-Guidance/Documentation/Time Log.pdf

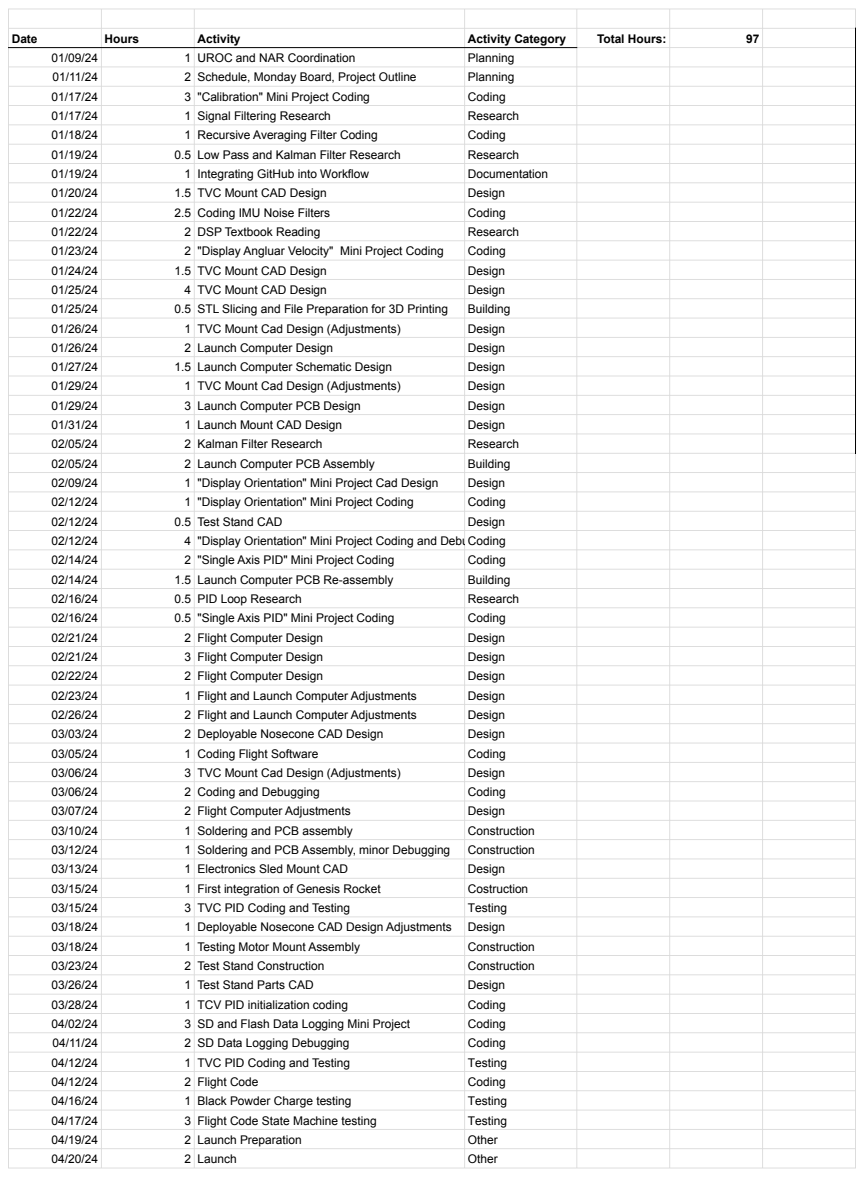
[picture p59: page 1]
Date; Hours; Activity; Activity Category; Total Hours:; 1 UROC and NAR Coordination; Planning; 2 Schedule, Monday Board, Project Outline; 3 "Calibration" Mini Project Coding; Coding; 1 Signal Filtering Research; Research; 1 Recursive Averaging Filter Coding; 0.5 Low Pass and Kalman Filter Research; 1 Integrating GitHub into Workflow; Documentation; 1.5 TVC Mount CAD Design; Design; 2.5 Coding IMU Noise Filters; 2 DSP Textbook Reading; 2 "Display Angluar Velocity" Mini Project Coding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

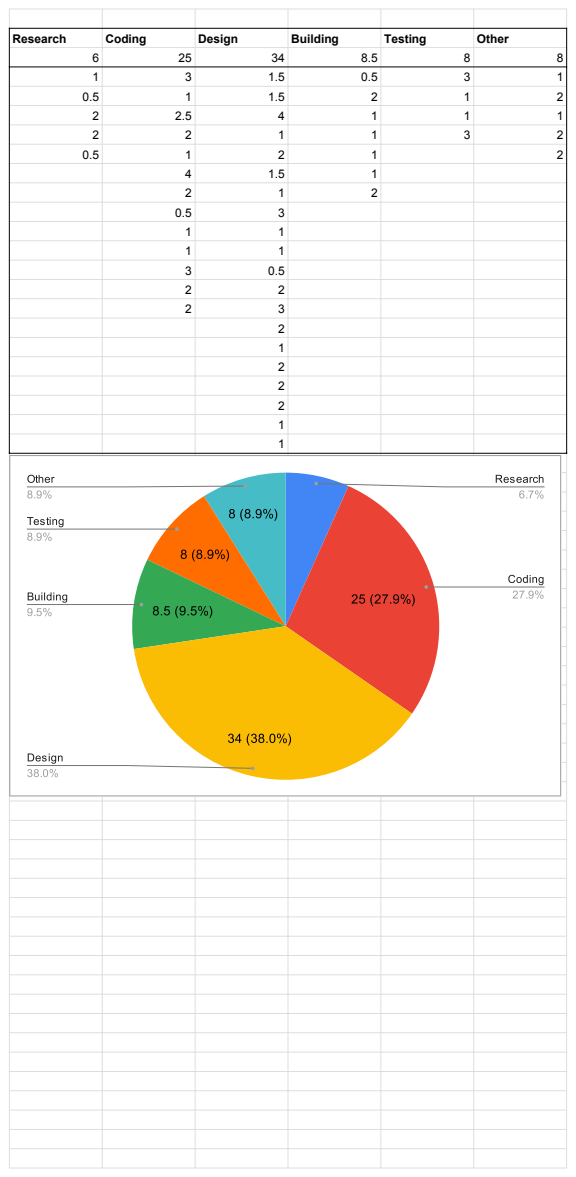
[picture p60: page 2]
Research; Coding; Design; Building; Testing; Other
