AlpineAce27/Senior-Project-TVC-Guidance/Documentation/Printable Remove Before Launch Tags x8.pdf

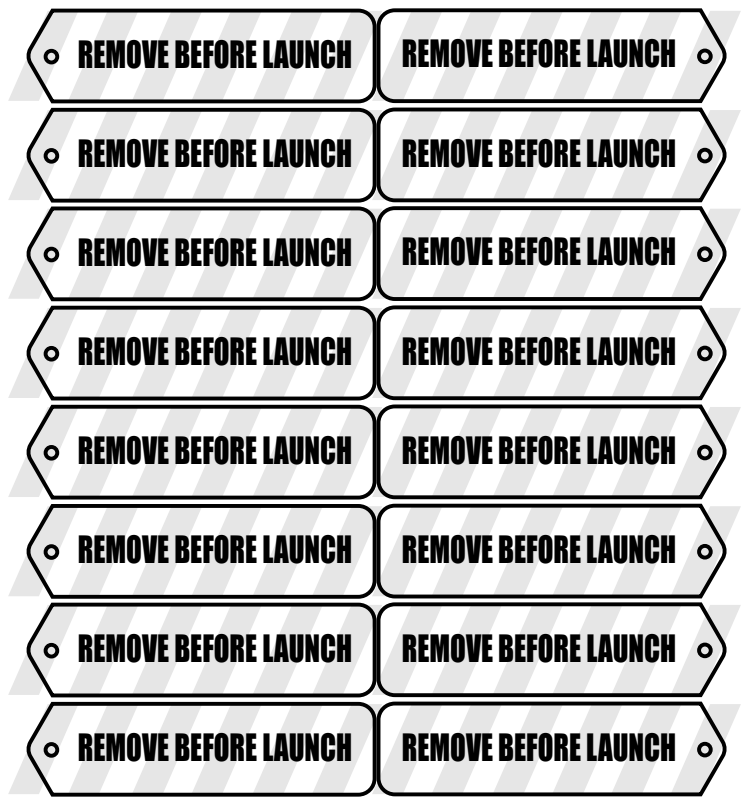
[picture p61: page 1]

REMOVE BEFORE LAUNCH
