AlpineAce27/Senior-Project-TVC-Guidance/Genesis Flight Computer/Code/GenesisFlightSoftware_V0.3/GenesisFlightSoftware_V0.3/GenesisFlightSoftware_V0.3.ino

#include "MPU6050.h" //The MPU6050 library
#include "Wire.h"    //I2C library
#include "SPI.h"     //SPI library
#include "math.h"    //needed to do more compelx maths like sine, cosine, and tangent
#include "SD.h"      //make sure this is the Teensyduino SD Card library
#include "Servo.h"  //make sure this is the Teensyduino Servo Card library
#include "Adafruit_BMP280.h" //BMP280 Barometer Library


//Objects: IMU, X and Z axis Servos, Aux Servos
MPU6050 imu1;
Adafruit_BMP280 bmp;
Servo servoX;
Servo servoZ;
Servo servoAux1;
Servo servoAux2;

//---------------------------------------------------------------PINS-------------------------------------------------------------------
const int Servo1Pin =   2;
const int Servo2Pin =   3;
const int Servo3Pin =   4;
const int Servo4Pin =   5;
const int buzzer =      6;
const int blueLED =     7;
const int redLED =      8;
const int greenLED =    9;
                      //11 is the MOSI pin    
                      //12 is the MISO pin
const int Aux14 =       14;
const int Aux15 =       15;
const int Aux16 =       16;
const int pyroPin =     17;
                      //18 is the SDA pin
                      //19 is the SCL pin
const int SDCS =        20;
const int FlashCS =     21;
const int Aux22 =       22;
const int arm =         23;



//---------------------------------------------------------------VARIABLES---------------------------------------------------------------

//Flight Logic Variables
bool armed = false;
bool inFlight = false;
bool dataTransferred = false;
bool apogeeReached = false;
int  dataThreshold = 100;
int  dataCount = 0;
long liftoffTime = 0;
float prevAccel = 0;

//IMU gyro variables
float gx;
float gy;
float gz;
int gxOffset;
int gyOffset;
int gzOffset;
float gyroScaleFactor = 65.5; //This value is based off of the MPU6050 datasheet, pg 12. We are using FS_SEL = 1 for +- 500 deg/sec
int FS_SEL = 1;

//IMU accelerometer variables
float ax;
float ay;
float az;
int axOffset;
int ayOffset;
int azOffset;
float accelScaleFactor = 4096; //This value is based off of the MPU6050 datasheet, pg 13. We are using AFS_SEL=2, for +-8 G's
int AFS_SEL = 2;

//IMU Calibration variables
float average;
float total;
int calibrationPoints = 4000;

//Angle variables, one for the set angle and one for the observed/measured angle
float angularVelX = 0;
float angularVelY = 0;
float angularVelZ = 0;
float xAngle = 0;
float yAngle = 0;
float zAngle = 0;

int maximumXdeflection = 25;
int maximumZdeflection = 25;
int xTVCinitial = 100;
int zTVCinitial = 97;
int xTVCAngle = xTVCinitial;
int zTVCAngle = zTVCinitial;

//Timing variables
float refresh = 50; //this is in hz
float deltaT = 1/refresh;
long loop_timer;

//====================================================================PID variables
float pGain = 0.6;
float iGain = 0;
float dGain = 0.1;

//x axis PID components
float previousXError = 0; 
float currentXError = 0;
float proportionalXError = 0;
float integralXError = 0;
float derivativeXError = 0;

//z axis PID components
float previousZError = 0;
float currentZError = 0;
float proportionalZError = 0;
float integralZError = 0;
float derivativeZError = 0;

//other variables
float xAngleDesired = 0;
float zAngleDesired = 0;
float acceptableMargin = 1; //this is the accetable deviation from 0 in degrees (+ and -)
float baroReading = 0;
float prevBaroReading = 0;
float tempReading;


//tone variables for the piezo buzzer
const int happyTone = 3300;
const int neutralTone = 3000;
const int sadTone = 2000;

//---------------------------------------------------------------SETUP---------------------------------------------------------------
void setup() 
{
  //wake up sequence
  tone(buzzer, sadTone);
  delay(100);
  tone(buzzer, neutralTone);
  delay(100);
  tone(buzzer, happyTone);
  delay(100);
  noTone(buzzer);
  digitalWrite(redLED, HIGH);
  delay(500);                
  digitalWrite(redLED, LOW); 
  digitalWrite(blueLED, HIGH);
  delay(500);
  digitalWrite(blueLED, LOW); 
  digitalWrite(greenLED, HIGH);   
  delay(500);
  digitalWrite(greenLED, LOW);
  
  //------------------------Initialize Components------------------
  Wire.begin();
  SPI.begin();
  Serial.begin(38400);
  
  //IMU
  imu1.initialize();
  imu1.setFullScaleGyroRange(FS_SEL);
  imu1.setFullScaleAccelRange(AFS_SEL);
  Serial.println("IMU Initialized");

  //SD Card

  /*
  if(!SD.begin(SDCS))
  {
    sadBeeps(); while(0==0){delay(10);}
  }
  else 
  {
    Serial.println("SD Card initialized.");
  }
  */
  
  if(!bmp.begin())
  {
    sadBeeps(); while(0==0){delay(10);}
  }
  else
  {
    Serial.println("Barometer initialized.");
  }
  
  
  //define outputs and inputst.
  pinMode(redLED, OUTPUT);
  pinMode(blueLED, OUTPUT);
  pinMode(greenLED, OUTPUT);
  pinMode(arm, INPUT_PULLUP);

  digitalWrite(greenLED, HIGH);
  happyBeeps();

  //We need to calibrate the IMU before we can effectively use it. Here we take many readings and averge them to get offset values
  for(int i = 1; i <= calibrationPoints; i++)
    {
      gx = imu1.getRotationX();            
      total = total + gx;   
    }
    //when the loop is finished, calculate the average of all the points and set it as the gyro X offset
    gxOffset = total/calibrationPoints;
  Serial.print("Gyro X Offset Value: "); Serial.println(gxOffset);
  total = 0;

  for(int i = 1; i <= calibrationPoints; i++)
    {
      gz = imu1.getRotationZ();            
      total = total + gz;    
    }
    //when the loop is finished, calculate the average of all the points and set it as the gyro Z offset
    gzOffset = total/calibrationPoints;
  Serial.print("Gyro Z Offset Value: "); Serial.println(gzOffset);
  total = 0;

  for(int i = 1; i <= calibrationPoints; i++)
    {
      gy = imu1.getRotationY();            
      total = total + gy;    
    }
    //when the loop is finished, calculate the average of all the points and set it as the gyro Z offset
    gyOffset = total/calibrationPoints;
  Serial.print("Gyro Y Offset Value: "); Serial.println(gyOffset);
  total = 0;

 //the arming key must be inserted for the program to continue
  Serial.println("Waiting on arming key");
  while (digitalRead(arm) == HIGH)
  {
    digitalWrite(blueLED, HIGH);
    armed = true;
  }

  //notify the user when the key is inserted
  Serial.println("Arming key present");
  digitalWrite(blueLED, LOW);
  armed = false;
  delay(500);

  //now that the arming key is inserted, we wait until it is removed to arm the vehicle and begin data logging
  while(digitalRead(arm) == LOW)
  {delay(1);}

  /*once the key is removed, notify the user with some lights and beeps, and wait 10 seconds for the vehicle to settle
  before taking accel movements to determine orientation.*/
  Serial.println("Vehicle Armed.");
  digitalWrite(redLED, HIGH);
  happyBeeps();
  armed = true;
  inFlight = false;
  
  //attach Servo's to their respective pins
  servoX.attach(Servo1Pin);
  servoX.write(xTVCAngle);
  servoZ.attach(Servo2Pin);
  servoZ.write(zTVCAngle);
  delay(5000);
  digitalWrite(redLED, LOW);

  /*once the vehicle is settled, use the accelerometers on the IMU to determine the current orientation of the vehicle 
  and assign them to the X Y and Z angle values. This will be the starting point for the control to kick in once the vehicle starts moving. */
  ax = (imu1.getAccelerationX() - axOffset)/accelScaleFactor;
  ay = (imu1.getAccelerationY() - ayOffset)/accelScaleFactor; //(this should equal 1 if the rocket is pointed up and level)
  az = (imu1.getAccelerationZ() - azOffset)/accelScaleFactor;
  xAngle = ((180/3.1415)*acos(ax/1)-90)*-1;
  zAngle = ((180/3.1415)*acos(az/1)-90)*-1;

  digitalWrite(greenLED, HIGH);
  //File myFile = SD.open("data.txt", FILE_WRITE);
  //myFile.println(millis() + "File Created.");
  Serial.println(millis() + "File Created.");
  //myFile.println("Starting Orientation  X:" + String(xAngle) + "  Z:" + String(zAngle));
  Serial.println("Starting Orientation  X:" + String(xAngle) + "  Z:" + String(zAngle));
  //myFile.close();
  digitalWrite(greenLED, LOW);
  //beep loudly to indicate startup
  neutralBeeps();
  digitalWrite(buzzer, HIGH);
  delay(2000);
  digitalWrite(buzzer, LOW);
  
}

//---------------------------------------------------------------LOOP---------------------------------------------------------------

void loop() 
{
  loop_timer = millis();
  //File myFile = SD.open("data.txt");

  //on the pad
  if(inFlight == false && armed == true)
  {
    ay = imu1.getAccelerationY()/accelScaleFactor;
    
    if(ay >= 1.2) 
    {
    digitalWrite(redLED, HIGH);
    liftoffTime = millis();
    inFlight = true; 
    //myFile.println(millis() + "Liftoff detected.");
    Serial.println(millis() + "Liftoff detected.");
    }
  }

  //ascent
  if(inFlight == true && apogeeReached == false)
  { //read the angular velocities from the sensor
    gx = imu1.getRotationX();
    gz = imu1.getRotationZ();
    //adjust these values using the scale factor from the data sheet
    angularVelX = (gx - gxOffset)/gyroScaleFactor;
    angularVelZ = (gz - gzOffset)/gyroScaleFactor;
    //convert the angular velocities into angular positions
    xAngle = angularVelX*deltaT + xAngle; 
    zAngle = angularVelZ*deltaT + zAngle;
    //Serial.print(xAngle); Serial.print(" | "); Serial.println(zAngle);
    //determine the error between where we are, and where we want to be
    currentXError = xAngleDesired - xAngle;
    currentZError = zAngleDesired - zAngle;
    //apply this error into the PID components
    proportionalXError = currentXError;
    proportionalZError = currentZError;
    integralXError = integralXError + currentXError*deltaT;
    integralZError = integralZError + currentZError*deltaT;
    derivativeXError = (currentXError - previousXError)/deltaT;
    derivativeZError = (currentZError - previousZError)/deltaT; 
    //multiply these errors by their repsective gains, add them togehter and write the new angle to the servo it to the servo
    xTVCAngle = xTVCAngle - (proportionalXError*pGain + integralXError*iGain + derivativeXError*dGain);
    zTVCAngle = zTVCAngle - (proportionalZError*pGain + integralZError*iGain + derivativeZError*dGain);
    //we dont want to stress the servos. for this reason we will put an effective maximum deflection value in, if the assigned value exceeds this maximum, we limit it
    if(xTVCAngle > xTVCinitial+maximumXdeflection) {xTVCAngle = xTVCinitial+maximumXdeflection;}
    if(xTVCAngle < xTVCinitial-maximumXdeflection) {xTVCAngle = xTVCinitial-maximumXdeflection;}
    if(zTVCAngle > zTVCinitial+maximumZdeflection) {zTVCAngle = zTVCinitial+maximumZdeflection;}
    if(zTVCAngle < zTVCinitial-maximumZdeflection) {zTVCAngle = zTVCinitial-maximumZdeflection;}
    //move the servos to the new angles
    servoX.write(xTVCAngle);
    servoZ.write(zTVCAngle);
    //update the errors in preparation for the next loop
    previousXError = currentXError;
    previousZError = currentZError;
    //log data
    String dataString = "";
    baroReading = bmp.readPressure();
    tempReading = bmp.readTemperature();                   
    ax = imu1.getAccelerationX()/accelScaleFactor;
    ay = imu1.getAccelerationY()/accelScaleFactor;
    az = imu1.getAccelerationZ()/accelScaleFactor;          
    gx = (imu1.getRotationX() - gxOffset)/gyroScaleFactor;
    gy = (imu1.getRotationY() - gyOffset)/gyroScaleFactor;
    gz = (imu1.getRotationZ() - gzOffset)/gyroScaleFactor;  
    dataString = String(millis()) + ", " + String(baroReading) + ", " + String(tempReading) + ", " + String(ax) + ", " + String(ay) + ", " + String(az) + ", " + String(gx) + ", " + String(gy) + ", " + String(gz) + ", " + String(xAngle)+ ", " + String(zAngle)+ ", " + String(xTVCAngle)+ ", " + String(zTVCAngle);    File myFile = SD.open("data.txt", FILE_WRITE);
    //myFile.println(dataString);
    
    //apogee detction
    if (baroReading < prevBaroReading) {dataCount++;}
    else {dataCount = 0;}
    
    if(millis() > (3500+liftoffTime))//=================================================================================this if statement is for testing
    //if (dataCount > dataThreshold)//===================================================================this if statement is for flight
      {
      digitalWrite(redLED, LOW);
      apogeeReached = true;
      //myFile.println(millis() + "Apogee detected.");
      digitalWrite(pyroPin, HIGH);
      digitalWrite(buzzer, HIGH);
      delay(1000);
      digitalWrite(pyroPin, LOW);
      digitalWrite(buzzer, LOW);
      servoX.write(xTVCinitial);
      servoZ.write(zTVCinitial);
      dataCount = 0;
      }
  }

  //descent
  if(inFlight == true && apogeeReached == true)
  {
    String dataString = "";
    baroReading = bmp.readPressure();
    tempReading = bmp.readTemperature();                   
    ax = imu1.getAccelerationX()/accelScaleFactor;
    ay = imu1.getAccelerationY()/accelScaleFactor;
    az = imu1.getAccelerationZ()/accelScaleFactor;          
    gx = (imu1.getRotationX() - gxOffset)/gyroScaleFactor;
    gy = (imu1.getRotationY() - gyOffset)/gyroScaleFactor;
    gz = (imu1.getRotationZ() - gzOffset)/gyroScaleFactor;  
    dataString = String(millis()) + ", " + String(baroReading) + ", " + String(tempReading) + ", " + String(ax) + ", " + String(ay) + ", " + String(az) + ", " + String(gx) + ", " + String(gy) + ", " + String(gz) + ", " + String(xAngle)+ ", " + String(zAngle)+ ", " + String(xTVCAngle)+ ", " + String(zTVCAngle);    File myFile = SD.open("data.txt", FILE_WRITE);
    //myFile.println(dataString);
    //myFile.close();
    
    //landing detection
    if (ax <= prevAccel+0.012 && ax >= prevAccel-0.012)
    {
      dataCount++; //Serial.println(dataCount);
    }
    else {dataCount = 0;}

    if (dataCount > dataThreshold)
    {
      //myFile.println(millis() + "Landing detected.");
      Serial.println("Landing Detected.");
      //myFile.close();
      while(1==1){digitalWrite(greenLED, HIGH); delay(1);}
    }
    prevAccel = ax;
  }
  //myFile.close();
  while(millis() < loop_timer + 1000/refresh){delay(1);} 
}

void happyBeeps()
{
  digitalWrite(greenLED, HIGH);
  tone(buzzer, happyTone);
  delay(100);
  noTone(buzzer);
  delay(100);
  digitalWrite(greenLED, LOW);
  tone(buzzer, happyTone);
  delay(250);
  noTone(buzzer);
}

void neutralBeeps()
{
  digitalWrite(blueLED, HIGH);
  tone(buzzer, neutralTone);
  delay(100);
  noTone(buzzer);
  delay(100);
  digitalWrite(blueLED, LOW);
  tone(buzzer, neutralTone);
  delay(250);
  noTone(buzzer);
}

void sadBeeps()
{
  digitalWrite(redLED, HIGH);
  tone(buzzer, sadTone);
  delay(100);
  noTone(buzzer);
  delay(100);
  digitalWrite(redLED, LOW);
  tone(buzzer, sadTone);
  delay(250);
  noTone(buzzer);
}
