AlpineAce27/Senior-Project-TVC-Guidance/(commit log)

2024-01-23 Filter applied
    Created a separate files for showing off calibration and degree/sec display.
2024-01-30 File Reorganization
    Added STLs for the TVC mount and organized files
    [Inner Gimbal Ring.stl, Inner Linkage Arm.stl, Motor Sleeve.stl, Outer Gimbal Ring.stl, Outer Linkage Arm.stl, Servo Horn Washers.stl]
2024-02-09 TVC and Mini Project updates
    [Base.stl, IMU Arm.stl, Inner Gimbal Ring.stl, Inner Linkage Arm.stl, Launch Mount.stl, Linkage Arm.stl, Motor Sleeve.stl, Outer Gimbal Ring.stl]
2024-02-09 Reorganization
    Files are are organized better
    [Base.stl, IMU Arm.stl, Inner Gimbal Ring.stl, Inner Linkage Arm.stl, Launch Mount.stl, Linkage Arm.stl, Motor Sleeve.stl, Outer Gimbal Ring.stl]
2024-02-10 Added Code
    added WIP code for the single axis PID controller
2024-02-12 Test Stand and Code Update
    Added STL's for a test stand and changed some code
    [Inner Ring.stl, Outer Ring.stl, Rocket Mount.stl]
2024-02-12 Servo Addition
2024-02-14 Code and File Consolidation
    [Base.stl, IMU Arm.stl, Linkage Arm.stl]
2024-02-22 added documentation
    [Nosecone.stl]
2024-03-12 Version 0.1
    added images, changed some code, added STLs
    [Base.stl, Case Bottom.stl, Case Top.stl, Fairing Half.stl, Inner Gimbal Ring.stl, Linkage.stl, Motor Sleeve.stl, Outer Gimbal Ring.stl]
2024-03-15 Code updates
    [Electronics Sled.stl, Nosecone.stl, PCB Breakout Board Brace Block.stl]
2024-03-28 Added angle initialization
    used the accelerometers to guess to initial angle the rocket starts at, providing an accurate starting point for TVC control
    [2x4 Mount.stl, Base.stl, Body1.stl, Case Top.stl, Electronics Sled.stl, Inner Ring-bodyTubeDia.stl, Inner Ring-skeletalFrameDia.stl, Outer Ring.stl]
2024-04-02 Update 2x4 Mount.stl
    [2x4 Mount.stl]
2024-04-02 Updated PID Miniproject STLs
    [Base.stl, IMU Arm.stl, Linkage Arm.stl]
2024-04-02 Added Data Logger Mini-project
    [Pad-Side Launch Mount.stl, Rocket-Side Launch Mount.stl]
2024-04-12 Flight Code and Testing Code Adjustments
    really filled out the flight code, PIDs still need some work. Flight code needs to be tested too
    [Ejection Charge Powder Container.stl, Outer Ring.stl, Thrust Meauring RC Motor Plate.stl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]
2024-04-12 STL updates
    [Ejection Charge Powder Container.stl, Recovery Piston Slider.stl]
2024-04-16 file organization
    [Base.stl, IMU Arm.stl, Linkage Arm.stl]
2024-04-16 Added PCB files and Schematics for the GLC
2024-04-17 Fixed some bugs in the TVC testing and flight code
    [GFC_Testing.ino, GenesisFlightSoftware_V0.3.ino]
2024-04-20 updates for day before maiden flight
    [Battery Spacer.stl]
